Nelsont345/Driver-Fingerprint-Scanner/Report/Screen Shots/Photo of Set up.jpg

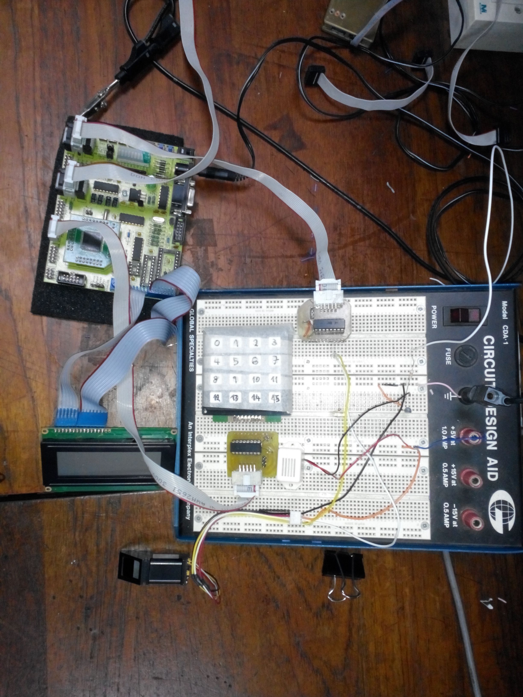
Report/Screen Shots/Photo of Set up.jpg
