Nelsont345/Driver-Fingerprint-Scanner/Report/Screen Shots/Welcome.jpg

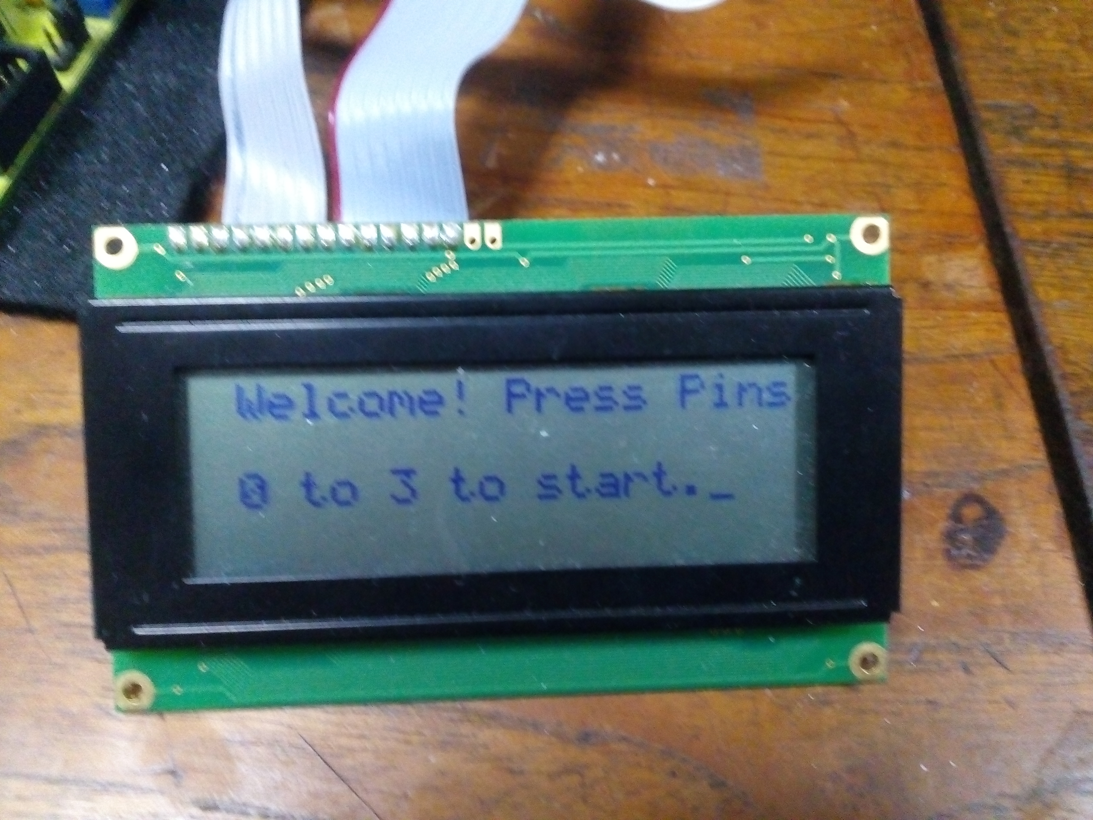
Report/Screen Shots/Welcome.jpg
