Nelsont345/Driver-Fingerprint-Scanner/README.md

# Driver-Fingerprint-Scanner
#A fingerprint scanner using a ATmega128 microprocessor
#and a Zhiantec zfm206 fingerprint module
