Nelsont345/Driver-Fingerprint-Scanner/PRoject Asssembly/version 12 working Action 1.txt

;Copyright (c) 2013 Manolis Agkopian		    
;See the file LICENCE for copying permission.	    ;
;;;;;;;;;;;;;;;;;;;;;;;;;;;;;;;;;;;;;;;;;;;;;;;;;;;;;

	.DEVICE ATmega128
	.include "m128def.inc"

;""""""""""""""""""""""""""""""""""""""""""""""""""""""""""""""""""""""
		jmp Init		                 ; jmp is 2 word instruction to set correct vector 

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

.org		$0080			; start address well above interrupt table

;""""""""""""""""""""""""""""""""""""""""""""""""""""""""""""""""""""""""""""

init:

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

.equ	testregister= 0x0352           ;used for interrupt
.equ	testregister1= 0x037B
.equ    testregister2 = 0x03A4
.equ    testregister3 = 0x03CD      ;not in use 
.equ    testregister4 = 0x03F6

.equ    testregister5 = 0x041F
.equ    testregister6 = 0x0448
.equ    testregister7 = 0x0471
.equ    testregister8 = 0x049A 
.equ	testregister9 = 0x04C3  

;*****    Registers    *****
.def	bitcounter  = R24				;??
.def	temp	    = R16			;COUNTER?
.def	UART_buffer = R23			;WHat IS BUFFER?

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

		;######################################################################

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

img2tBuff1:
.db $EF,$01,$FF,$FF,$FF,$FF,$01,$00,$04,$02,$1,$00,$08,$0

img2tBuff2:
.db $EF,$01,$FF,$FF,$FF,$FF,$01,$00,$04,$02,$2,$00,$09,$0

regmodel:
.db $EF,$01,$FF,$FF,$FF,$FF,$01,$00,$03,$05,$00,$09    

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

PreciseMatch:
.db $EF,$01,$FF,$FF,$FF,$FF,$01,$00,$03,$03, $00, $07,$08,$00

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

;****************************************************
;**********************CODE HERE*********************
;****************************************************

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

; 12 cycles here (without delays)
uart_send_next_bit:	
	brcc	uart_send_1
	cbi		UART_TxPort, TxD
	rjmp	uart_wait

uart_send_1:	
	sbi		UART_TxPort, TxD
	nop

uart_wait:	
	rcall 	UART_delay	
	rcall 	UART_delay

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

UART_get_byte:	
	ldi 	bitcounter, 9

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

; 10 cycles here (without delays)
uart_get_bit:	
	rcall 	UART_delay	
	rcall 	UART_delay		

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

uart_bit_done:	
	ret

;****************************************************
;*****                UART DELAY                *****
;****************************************************
; 3*b + const_delay_cycles
UART_delay:	
	lds		temp, DELAY_VALUE
UART_delay1:	

	dec		temp
	brne	UART_delay1
	nop
	;pop r16
	ret

uart_init:
              ;set portD as I/O

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

	ldi temp, $01
	ret
;**************************  MAIN ***************************************
;***********************************************************************
;******************************************************************
;******************************************************************
;******************************************************************
;******************************************************************
;******************************************************************
;******************************************************************
;******************************************************************
;******************************************************************
;******************************************************************
;******************************************************************

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

; +++++++++++++++++++++++++++++++++  ACTION 1 +++++++++++++++++++++++++++++++++++
action1:
	rcall Print1
Print2:
	ldi YH, high(testregister2) ;3A4     regmodel gets recorded
	ldi YL, low(testregister2)
	rcall send_genimg
	rcall BigDEL
	rcall BigDEL
	/*
	push r20
	lds r20, 0x035B     ;change
	cpi  r20, $00
	brne Print2
	pop r20	
	*/
	ldi YH, high(testregister3) ;3CD    Match gets recorded
	ldi YL, low(testregister3)
	rcall send_img2tBuff2	
	rcall BigDEL
	rcall BigDEL
	ldi YH, high(testregister4) ;3fB     Match gets recorded
	ldi YL, low(testregister4)
	rcall send_regmodel
	rcall BigDEL
	rcall BigDEL
	
	push r20
	ldi r20, $BB
	out portb, r20
		pop r20	
	rcall BigDEL
	ldi YH, high(testregister5) ;41F     Match gets recorded
	ldi YL, low(testregister5)
	rcall send_PreciseMatch
	rcall BigDEL
	rcall BigDEL

	rcall compare_basic2 
	ret 
; +++++++++++++++++++++++++++++++++  ACTION 2 +++++++++++++++++++++++++++++++++++
action2:   ;Keep
	out portb, r30
	rcall send_genimg	

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

	ret

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

	rcall send_LoadCharBuffer1
	rcall send_LoadCharBuffer2

	rcall send_PreciseMatch
	rcall compare_basic2
	rcall megadel
	;rcall send_LoadCharBuffer2    ;load charbuffer from location 1, as Char 2

	;rcall send_regmodel
	;rcall save_data_start5
	;rcall send_Search
	;rcall save_data_start49A         ;match before storing
	;rcall compare_basic2 
	;rcall megadel

	ret

Print1:
	ldi YH, high(testregister) 
	ldi YL, low(testregister)    ;352     ;getting ff, expecting 00
	rcall send_genimg		   
	rcall BigDEL
	rcall BigDEL

	ldi YH, high(testregister1) ;37B
	ldi YL, low(testregister1) 
	rcall send_img2tBuff1  
	rcall BigDEL
	rcall BigDEL
	push r19
	ldi r19, $AA
	out portb, r19
	pop r19	
	ret

;XXXXXXXXXXXXXXXXXXXXXXXXXXXXXXX  Beginning OF RETURN    XXXXXXXXXXXXXXXXXXXXXXXXXXXXXXXXXXXXXXXXX
;XXXXXXXXXXXXXXXXXXXXXXXXXXXXXXX  Beginning OF RETURN    XXXXXXXXXXXXXXXXXXXXXXXXXXXXXXXXXXXXXXXXX

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

;^^^^^^^^^^^^^^^^^^^^^^^^^^^^^^^^^^DATABASE TO SRAM^^^^^^^^^^^^^^^^^^^^^^^^^^^^^^^^^^

DATABASE_TO_SRAM: ;saves to 0x0300
push r20
compare_database:

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

	;end if counted
	cpi r20, $0
	breq program_to_memory_end
	rjmp program_to_memory

program_to_memory_end:
	pop r20
	ret

;^^^^^^^^^^^^^^^^^^^^^^^^^^^^^^^^^^DATABASE TO SRAM  END^^^^^^^^^^^^^^^^^^^^^^^^^^^^^^^^^^
 ;*********************************COMPARING1**************************************

; in this routine we are going to compare 2 sram databases
compare_basic2:

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

Comp1Out2Z:	;the one we compare to

			  LDI ZH, HIGH(compare_address)    ;address for comparison 
              LDI ZL, LOW(compare_address)
			  ret
Comp1Out2Y:
              ldi YL, low(testregister5)           ;saved output from MAtch
			  ldi YH, high(testregister5) 
			  ret

Comp1More2:

			ld r20, Z+
			ld r17, Y+

			inc r18

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

			cpi r18, 10 ; compare when end the cycle		 ;chnaged to 8 for matching	
			brne Comp1More2

Comp1End2:     

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

			pop r18
			pop r21
			pop r20
			pop r17
			ret

statefalse2:
	push r22
	ldi r22, $0F
	out portB, r22
	 ;ldi r25, 0  ;to end the loop
	pop r22
	rcall bigdel
	;rjmp statefalse2

	pop r18
	pop r21
	pop r20
	pop r17
	ret
	;rjmp sendloop

;XXXXXXXXXXXXXXXXXXXXXXXXXXXXXXX  END OF RETURN    XXXXXXXXXXXXXXXXXXXXXXXXXXXXXXXXXXXXXXXXX
;XXXXXXXXXXXXXXXXXXXXXXXXXXXXXXX  END OF RETURN    XXXXXXXXXXXXXXXXXXXXXXXXXXXXXXXXXXXXXXXXX

;&&&&&&&&&&&&&&&&&&&&&&&&&&&&&&&  SENDING PACKAGES &&&&&&&&&&&&&&&&&&&&&&&&&&&&&&&&&&&&&&&&&

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

;*************************************SEND BYTE BY BYTE****************************************
	  
Mess1Out:
			push r17

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

;*************************************** LCD ROutines

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

;%%%%%%%%%%%%%%%%%%%%%%%%%%%%    Interrupt   %%%%%%%%%%%%%%%%%%%%%%%%%%%%%%%

save_data_start352:

push r17
lds r17, UDR1
;out portb, r17
st Y+, r17 ; store bit received to UART to memomry location
pop r17
;rcall megadel
;cpi YL, $61
;breq end
reti

/*
end:
	cli
	ldi YL, $52
	ret
*/
/*

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

;%%%%%%%%%%%%%%%%%%%%%%%%%%%%    10th    %%%%%%%%%%%%%%%%%%%%%%%%%%%%%%%
save_data_start49A:
	push r20

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

	 ldi ZH, high(testregister92) ;create 16 bit address, create *2?
	 ldi ZL, low(testregister92)

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

	 ;%%%%%%%%%%%%%%%%%%%%%%%%%%%%%%%%%%%%%%%%%%%%%%%%

*/

megadel:
	rcall BigDEL
	rcall BigDEL
	rcall BigDEL
	rcall BigDEL
	rcall BigDEL
	rcall BigDEL
	rcall BigDEL
	rcall BigDEL
	rcall BigDEL
	rcall BigDEL
	ret

; ~~~~~~~~~~~~~~~~~~~~~~~~~~~~~~~~~~~~~~~~ WAIT FOR  BUTTION PRESS AND MOVE SOMWEHRE ~~~~~~~~~~~

waitforbuttonpress:
	
    ;ldi r21,$00
	in r21, PIND

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

	cpi r21, $EF ; PIN4
	breq action4call ;Action 4

	ret

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
