Nelsont345/Driver-Fingerprint-Scanner/PRoject Asssembly/version 4.txt

;Copyright (c) 2013 Manolis Agkopian		    
;See the file LICENCE for copying permission.	    ;
;;;;;;;;;;;;;;;;;;;;;;;;;;;;;;;;;;;;;;;;;;;;;;;;;;;;;

	.DEVICE ATmega128
	.include "m128def.inc"

;***** Pin definitions *****
.equ	UART_TxPort = PORTD    ;set port D aS OUTPUT FOR TRANSMIT
.equ	UART_TxDDR  = DDRD				;DIRECTION REGISTER
.equ	UART_RxPin  = PIND				;sET PIN D FOR READ
.equ	UART_RxDDR  = DDRD					;DIRECTION REGISTER
.equ	RxD	= 2							;set pin  2 as receive, might be a different pin
.equ	TxD	= 3								;set pin 3 as transmit

;.equ	savedregister=0x0200      ;Address in SRAM, where the new database will be stored
.equ	savedregister=0x0300      ;Address in SRAM, where the new database will be stored
.equ	compare_address = 0x0C00

;*****    Registers    *****
.def	bitcounter  = R24				;??
.def	temp	    = R17			;COUNTER?
.def	UART_buffer = R23			;WHat IS BUFFER?

;*****  Speed setting  *****
.equ	CRYSTAL_FREQ = 8000000   ;SET READ/ WRITE TO BE EQUAL, 8MHZ, now 1
.equ	BAUD 		 =  57600  ;57600     ;bits per second, rate ;9600

;*****       Etc       *****
.equ	stop_bits 	       = 1     ;STOPS READING
; hand-picked for easier auto-baud calculations (no division)
.equ	cycles_per_bit 	   = 12 ;without delays + 4*nop
.equ	const_delay_cycles = 9	;rjmp + ret + 2*nop

; byte in ram that keeps speed
.dseg
DELAY_VALUE: .byte 1        ;assign memory for clock speed value?
.cseg

;***** Precalculations *****
;pure cycles necessary per bit
.equ	c = CRYSTAL_FREQ / BAUD			;relates clock speed to transmission
;delay cycles
.equ	d = (c - cycles_per_bit - 2*const_delay_cycles)/2
;delay value	
.equ	b = d / 3						;divison by 3 of d, definition

; throw error if we're out of bounds
.if b > 255
	.error "Baud rate is too low!"		;check if transmission speed is correct
.elif b <= 0
	.error "Baud rate is too high!"
.endif

; ******* Port B Setup Code ****  
		ldi r16, $FF		; will set to outputs so i cab use Leds for debugging
		out DDRB , r16		; Port B Direction Register
		ldi r16, 00		; Who cares what is it....
		out PORTB, r16		; Port B value

		ldi r16, $0F		; Stack Pointer Setup
		out SPH,r16			; Stack Pointer High Byte 
		ldi r16, $FF		; Stack Pointer Setup 
		out SPL,r16			; Stack Pointer Low Byte 
rjmp main
;****************************************************
;**********************CODE HERE*********************
;****************************************************

;****************************************************
;*****                 SEND BYTE                *****
;****************************************************
; UART_buffer -> UART
UART_send_byte:	
	ldi		bitcounter, 9 + stop_bits ;CHECK IF CORRECRT, 7 + stop_bits
	com		UART_buffer	
	sec		

; 12 cycles here (without delays)
uart_send_next_bit:	
	brcc	uart_send_1
	cbi		UART_TxPort, TxD
	rjmp	uart_wait

uart_send_1:	
	sbi		UART_TxPort, TxD
	nop

uart_wait:	
	rcall 	UART_delay	
	rcall 	UART_delay

	nop	nop nop nop
	lsr		UART_buffer
	dec		bitcounter		
	brne	uart_send_next_bit
					
	sbi		UART_TxPort, TxD
	ret		
		
;****************************************************
;*****                 GET BYTE                 *****
;****************************************************
; UART -> UART_buffer
UART_get_byte:	
	ldi 	bitcounter, 9

uart_wait_for_start:	
	sbic 	UART_RxPin, RxD	
	rjmp 	uart_wait_for_start
	;synchronize for 0.5 bit length
	rcall 	UART_delay	

; 10 cycles here (without delays)
uart_get_bit:	
	rcall 	UART_delay	
	rcall 	UART_delay		

	clc			
	sbic 	UART_RxPin, RxD	;RxD is a pin where out data will appear bit by bit
	sec			
	
	nop	nop nop nop
	dec 	bitcounter		
	breq 	uart_bit_done	
				
	ror 	UART_buffer		
	rjmp 	uart_get_bit	

uart_bit_done:	
	ret

;****************************************************
;*****                UART DELAY                *****
;****************************************************
; 3*b + const_delay_cycles
UART_delay:	
	lds		temp, DELAY_VALUE
UART_delay1:	
	dec		temp
	brne	UART_delay1
	nop
	ret

;****************************************************
;*****              UART AUTO-BAUD              *****
;****************************************************
; calculates calc_b after receiving 0x55
; calc_b -> temp
; intermediate result is c/6
; sbis (2) + inc (1) + breq (2) + nop (1)
/*
UART_autocalibrate:
	clr 	temp
	
uart_cal_wait_start:	
	sbic 	UART_RxPin, RxD	
	rjmp 	uart_cal_wait_start

uart_cal_wait_bit:	
	sbis 	UART_RxPin, RxD	
	rjmp 	uart_cal_wait_bit

uart_measure_bit:
	sbis 	UART_RxPin, RxD		
	rjmp 	uart_calibration_done
	nop
	inc		temp
	breq	uart_calibration_fail

uart_calibration_done:
	; b = c/6 - cycles_per_bit/6 - const_delay_cycles/3
	; temp = c/6
	cpi		temp, cycles_per_bit/6
	brlo	uart_calibration_fail
	subi	temp, cycles_per_bit/6

	cpi		temp, const_delay_cycles/3
	brlo	uart_calibration_fail
	subi	temp, const_delay_cycles/3

	sts		DELAY_VALUE, temp

uart_calibration_fail:
	ret
*/
;****************************************************
;*****               UART REINIT                *****
;****************************************************
; just resets DELAY_VALUE to default
uart_reinit:

	in		temp, UART_TxDDR
	ori		temp, (1<<TxD)
	out		UART_TxDDR, temp
	sbi		UART_TxPort, TxD

	in		temp, UART_RxDDR
	andi	temp, ~(1<<RxD) 
	out		UART_RxDDR, temp

	ldi		temp, b
	sts		DELAY_VALUE, temp
	ret

	ldi temp, $01
	ret
;**************************  MAIN ***************************************
;***********************************************************************
;******************************************************************
;******************************************************************
;******************************************************************
;******************************************************************
;******************************************************************

main:
	;rcall Idisp
	rcall uart_reinit
	;rcall Mess1Out
	;rcall save_data_start
sendloop:

	;ldi UART_buffer, $40
	; call sending rmess routinge
	;rcall Mess1Out
	;call save_data_start
	rcall DATABASE_TO_SRAM
	;rcall compare_basic
	
	;lds r16, 0x0309
	;out portb, r16
	;mov r22, UART_buffer
	;out portb, r22
	;rcall DEL49ms

	;rcall UART_send_byte
	; UART BUFFER is the data to send

	rjmp sendloop

;XXXXXXXXXXXXXXXXXXXXXXXXXXXXXXX  Beginning OF RETURN    XXXXXXXXXXXXXXXXXXXXXXXXXXXXXXXXXXXXXXXXX
;XXXXXXXXXXXXXXXXXXXXXXXXXXXXXXX  Beginning OF RETURN    XXXXXXXXXXXXXXXXXXXXXXXXXXXXXXXXXXXXXXXXX

save_data_start:
	push r20
	 ldi XH, high(savedregister*2) ;create 16 bit address
	 ldi XL, low(savedregister*2)
	 ldi r25, 12
	 ; memory initisised
save_data: ; 12 bytes to collect - collect byte by byte
	rcall UART_get_byte	
	mov r22, UART_buffer
	;out portb, r22
	;set up memory for input i.e what is saved in r22
	;use SRAM 
	st X+, r22         ;store 8 bits wiht a 16 bit address in SRAM
	;lds r20, 0x0208     ;verification  steps
	;cpi r20, $03
	;breq stahp

	Dec r25
	cpi  r25, 0
	brne save_data ; if it is zero just go on
	pop r20
	ret
	
stahp:           ;verifcation steps
	out portB, r20
	ret

;^^^^^^^^^^^^^^^^^^^^^^^^^^^^^^^^^^DATABASE TO SRAM^^^^^^^^^^^^^^^^^^^^^^^^^^^^^^^^^^

DATABASE_TO_SRAM: ;saves to 0x0C00  WHYYY WHY THEFUCK WHYY I HATE THIS SO MUCH FUCK YOU AVR ASSEWMBLY
push r20
compare_database:
;.db $EF, $01, $FF, $FF, $FF, $FF, $07,$00, $03, $00, $00, $0C  ;changed Byte 9 from 02 to 00
.db $FF, $FF, $FF, $FF, $FF, $FF, $FF,$FF, $FF, $FF, $FF, $FF 
makingZalocation:
	ldi XH, high(compare_address*2) ;create 16 bit address
	ldi XL, low(compare_address*2)

	ldi ZH, HIGH(compare_database*2)  ;
    ldi ZL, LOW(compare_database*2)
	ldi r20, 12  ;counter

	;address
	
program_to_memory:
	lpm 
	;mov r19, r0 ;r19 cointans byte by byte
	ADIW ZL, $01
	dec r20
	
	;now you have data in r19 and you want to store it
	
	st X+, r0

	;end if counted
	cpi r20, $0
	breq program_to_memory_end
	rjmp program_to_memory

program_to_memory_end:
	pop r20
	ret

;^^^^^^^^^^^^^^^^^^^^^^^^^^^^^^^^^^DATABASE TO SRAM  END^^^^^^^^^^^^^^^^^^^^^^^^^^^^^^^^^^
 ;*********************************COMPARING**************************************

 ; this should be loaded only once

generateX:
.db 0x300, 0x301, 0x302, 0x303, 0x304, 0x305, 0x306, 0x307, 0x308, 0x309, 0x310, 0x311
ret

compare_data:
; this is responce code
;.db $0A, $00, $00, $03, $00, $07, $FF, $FF, $FF, $FF, $01, $EF
.db $EF, $01, $FF, $FF, $FF, $FF, $07,$00, $03, $02, $00, $0C

compare_basic:

ldi r20, $02 ;means nothing
ldi r18, 0  ;means nothing too
LDI r25, 12 ;number of characters or bytes ; this displays the number of r18 ; to send command 13

; po0int x to the memory
;ldi XL, low(generateX*2)
;ldi XH, high(generateX*2) ; was senddataregister

; do not repeat the thing above

Comp1Out:	;the one we compare to

			  LDI ZH, HIGH(compare_data*2)
              LDI ZL, LOW(compare_data*2)
              
Comp1More:
              LPM  ;isssue loading SRAM and incrementing

			  ; at this point we have Z(compare) in r18
			  ;we want to move this to store in different register
			  mov r19, r0 ; r19 is out test data from Z(compare message)
			  ADIW ZL, $01
			  ;now get X stuff in the memory
			  ;rcall generateX
			  ldi zL, low(generateX*2)
			  ldi zH, high(generateX*2)
			  lpm ; do not know shy this is here
			  mov r21,r0 ; move the X from r0
			  ld r18, X+ ; not sure if it is decremnenting  ;X is just r26?
			  ; now you have the value  of memory address in r18 one by one
				; r18 is X, r19 is Z
			   
			  ;rcall BigDEL
              cp r19, r18	;compaer X (memory) and Z		  ( message database)
			  brne statefalse
			  ;out portB, r20
			;rcall UART_delay
			;rcall bigdel
			;rcall bigdel
			;rcall bigdel
			;rcall bigdel

			  DEC r25
			  ;ADIW XL, $01
			  ADIW ZL, $01
			  cpi r25, $0			 
			  breq Comp1End
			  ;ADIW ZL, $01
			  rjmp Comp1More
			  ; if r18>0 then retrurn to mess1more
Comp1End:     

			rjmp sendloop

statefalse:
	push r22
	ldi r22, $0F
	out portB, r22
	; ldi r25, 0  to end the loop
	pop r22
	ret
	;rjmp sendloop

;XXXXXXXXXXXXXXXXXXXXXXXXXXXXXXX  END OF RETURN    XXXXXXXXXXXXXXXXXXXXXXXXXXXXXXXXXXXXXXXXX
;XXXXXXXXXXXXXXXXXXXXXXXXXXXXXXX  END OF RETURN    XXXXXXXXXXXXXXXXXXXXXXXXXXXXXXXXXXXXXXXXX

Mess1:
;.db $0F, $0

;.db $0,$0, $FF, $FF ,$0,$0
;.db $0F, $0

;Handshake
;.db $EF,$01,$FF,$FF,$FF,$FF,$01,$00,$04,$17,$00,$00,$1C,$00

;genimg
.db $EF,$01,$FF,$FF,$FF,$FF,$01,$00,$03,$01,$00,$05,$01,$00

;.db $0F, $0F
;
Mess1Out:
push r17
              LDI ZH, HIGH(2*Mess1)
              LDI ZL, LOW(2*Mess1)
              LDI r18, 12 ;number of characters or bytes ; this displays the number of r18 ; to send command 13
Mess1More:
              LPM 
              MOV r17, r0
              mov UART_buffer,r17
			  rcall UART_send_byte
              ;rcall Mess1LCD ; send it To LCD
			  ;rcall busylcd
              
			  ;delay this
			
			;rcall UART_delay
			;rcall UART_delay
			rcall UART_delay

			  DEC r18
			  cpi r18, $0
			  breq Mess1End
			  ADIW ZL, $01
			  rjmp Mess1More
			  ; if r18>0 then retrurn to mess1more
Mess1End:     
			pop r17
			ret

;*************************************** LCD ROutines

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

        ret              ;return if clear
;
;********************   DELAY ROUTINES ********************************************
BigDEL:
             rcall Del49ms
             rcall Del49ms
             rcall Del49ms
             rcall Del49ms
             rcall Del49ms
             ret
;
DEL15ms:
;
; This is a 15 msec delay routine. Each cycle costs
; rcall           -> 3 CC
; ret              -> 4 CC
; 2*LDI        -> 2 CC 
; SBIW         -> 2 CC * 19997
; BRNE        -> 1/2 CC * 19997
; 

            LDI XH, HIGH(19997)
            LDI XL, LOW (19997)
COUNT:  
            SBIW XL, 1
            BRNE COUNT
            RET
;
DEL4P1ms:
            LDI XH, HIGH(5464)
            LDI XL, LOW (5464)
COUNT1:
            SBIW XL, 1
            BRNE COUNT1
            RET 
;
DEL100mus:
            LDI XH, HIGH(131)
            LDI XL, LOW (131)
COUNT2:
            SBIW XL, 1
            BRNE COUNT2
            RET 
;
DEL49ms:
            LDI XH, HIGH(65535)
            LDI XL, LOW (65535)
COUNT3:
            SBIW XL, 1
            BRNE COUNT3
            RET
