Nelsont345/Driver-Fingerprint-Scanner/PRoject Asssembly/version 5, responds to finger.txt

;Copyright (c) 2013 Manolis Agkopian		    
;See the file LICENCE for copying permission.	    ;
;;;;;;;;;;;;;;;;;;;;;;;;;;;;;;;;;;;;;;;;;;;;;;;;;;;;;

	.DEVICE ATmega128
	.include "m128def.inc"

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

;.equ	savedregister=0x0200      ;Address in SRAM, where the new database will be stored
.equ	savedregister=0x0300      ;Address in SRAM, where the new database will be stored
.equ	compare_address = 0x0400

;*****    Registers    *****
.def	bitcounter  = R24				;??
.def	temp	    = R16			;COUNTER?
.def	UART_buffer = R23			;WHat IS BUFFER?

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

; 12 cycles here (without delays)
uart_send_next_bit:	
	brcc	uart_send_1
	cbi		UART_TxPort, TxD
	rjmp	uart_wait

uart_send_1:	
	sbi		UART_TxPort, TxD
	nop

uart_wait:	
	rcall 	UART_delay	
	rcall 	UART_delay

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

uart_wait_for_start:	
	sbic 	UART_RxPin, RxD	
	rjmp 	uart_wait_for_start
	;synchronize for 0.5 bit length
	rcall 	UART_delay	

; 10 cycles here (without delays)
uart_get_bit:	
	rcall 	UART_delay	
	rcall 	UART_delay		

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

uart_bit_done:	
	ret

;****************************************************
;*****                UART DELAY                *****
;****************************************************
; 3*b + const_delay_cycles
UART_delay:	
	lds		temp, DELAY_VALUE
UART_delay1:	
	dec		temp
	brne	UART_delay1
	nop

	ret

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

uart_cal_wait_bit:	
	sbis 	UART_RxPin, RxD	
	rjmp 	uart_cal_wait_bit

uart_measure_bit:
	sbis 	UART_RxPin, RxD		
	rjmp 	uart_calibration_done
	nop
	inc		temp
	breq	uart_calibration_fail

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

	cpi		temp, const_delay_cycles/3
	brlo	uart_calibration_fail
	subi	temp, const_delay_cycles/3

	sts		DELAY_VALUE, temp

uart_calibration_fail:
	ret
*/
;****************************************************
;*****               UART REINIT                *****
;****************************************************
; just resets DELAY_VALUE to default
uart_reinit:

	in		temp, UART_TxDDR
	ori		temp, (1<<TxD)
	out		UART_TxDDR, temp
	sbi		UART_TxPort, TxD

	in		temp, UART_RxDDR
	andi	temp, ~(1<<RxD) 
	out		UART_RxDDR, temp

	ldi		temp, b
	sts		DELAY_VALUE, temp
	ret

	ldi temp, $01
	ret
;**************************  MAIN ***************************************
;***********************************************************************
;******************************************************************
;******************************************************************
;******************************************************************
;******************************************************************
;******************************************************************
;******************************************************************
;******************************************************************
;******************************************************************
;******************************************************************
;******************************************************************

main:                                ;!!!!!!!!!!!!RUNS ONCE HERE
	;rcall Idisp
	rcall uart_reinit
	rcall DATABASE_TO_SRAM ;this takes the compasioson message and saves that in memorry at 0x0400
	
sendloop:
	
	rcall Mess1Out ; this send message to the deiv ce
	rcall save_data_start ; this takes the message from device and savedss to sram, at  0x0300
	rcall compare_basic2
	;ldi UART_buffer, $40
	; call sending rmess routinge
	;rcall Mess1Out
	;call save_data_start

	;rcall compare_basic2
	
	;lds r16, 0x0309
	;out portb, r16
	;mov r22, UART_buffer
	;out portb, r22
	;rcall DEL49ms

	;rcall UART_send_byte
	; UART BUFFER is the data to send

	rjmp sendloop

;******************************************************************
;******************************************************************
;******************************************************************
;******************************************************************
;******************************************************************

;XXXXXXXXXXXXXXXXXXXXXXXXXXXXXXX  Beginning OF RETURN    XXXXXXXXXXXXXXXXXXXXXXXXXXXXXXXXXXXXXXXXX
;XXXXXXXXXXXXXXXXXXXXXXXXXXXXXXX  Beginning OF RETURN    XXXXXXXXXXXXXXXXXXXXXXXXXXXXXXXXXXXXXXXXX

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

;^^^^^^^^^^^^^^^^^^^^^^^^^^^^^^^^^^DATABASE TO SRAM^^^^^^^^^^^^^^^^^^^^^^^^^^^^^^^^^^

DATABASE_TO_SRAM: ;saves to 0x0C00  
push r20
compare_database:
.db $EF, $01, $FF, $FF, $FF, $FF, $07,$00, $03, $00, $00, $0A  ;changed Byte 9 from 02 to 00  ;cagnged byte 1 from EF to EE
;.db $11, $11, $FF, $FF, $FF, $00, $FF,$FF, $FF, $11, $FF, $AA 
makingZalocation:
	ldi XH, high(compare_address) ;create 16 bit address?
	ldi XL, low(compare_address)  ;Leave as 8 bit

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

	;end if counted
	cpi r20, $0
	breq program_to_memory_end
	rjmp program_to_memory

program_to_memory_end:
	pop r20
	ret

;^^^^^^^^^^^^^^^^^^^^^^^^^^^^^^^^^^DATABASE TO SRAM  END^^^^^^^^^^^^^^^^^^^^^^^^^^^^^^^^^^
 ;*********************************COMPARING1**************************************
 ;$$$$$$$$$$$$$$$$$$$$$$$$$$$$$$$$$$$$$$$$$$$$$$$$$$$$$$$$$$$$$$$$$$$$$$$$$$$$$$$$$$$$$$

 ; this should be loaded only once
 /*

generateX:
.db 0x300, 0x301, 0x302, 0x303, 0x304, 0x305, 0x306, 0x307, 0x308, 0x309, 0x310, 0x311
ret

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

compare_basic:

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

; do not repeat the thing above

Comp1Out:	;the one we compare to

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

			rjmp sendloop

statefalse:
	push r22
	ldi r22, $0F
	out portB, r22
	; ldi r25, 0  to end the loop
	pop r22
	ret
	;rjmp sendloop
*/
 ;$$$$$$$$$$$$$$$$$$$$$$$$$$$$$$$$$$$$$$$$$$$$$$$$$$$$$$$$$$$$$$$$$$$$$$$$$$$$$$$$$$$$$$
  ;*********************************COMPARING2*************************************

; in this routine we are going to compare 2 sram databases
compare_basic2:

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

Comp1Out2Z:	;the one we compare to

			  LDI ZH, HIGH(compare_address)   
              LDI ZL, LOW(compare_address)
			  ret
Comp1Out2Y:
              ldi YL, low(savedregister)
			  ldi YH, high(savedregister) 
			  ret

Comp1More2:
			;load Z to r20

			ld r20, Z+
			ld r17, Y+

			inc r18

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

			cpi r18, 12 ; compare when end the cycle			
			brne Comp1More2

Comp1End2:     
			pop r17
			pop r20
			push r21
			push r18
			rjmp sendloop

statefalse2:
	push r22
	ldi r22, $0F
	out portB, r22
	 ;ldi r25, 0  ;to end the loop
	pop r22
	rcall bigdel
	rcall bigdel
	;rjmp statefalse2
	ret
	;rjmp sendloop

;XXXXXXXXXXXXXXXXXXXXXXXXXXXXXXX  END OF RETURN    XXXXXXXXXXXXXXXXXXXXXXXXXXXXXXXXXXXXXXXXX
;XXXXXXXXXXXXXXXXXXXXXXXXXXXXXXX  END OF RETURN    XXXXXXXXXXXXXXXXXXXXXXXXXXXXXXXXXXXXXXXXX

Mess1:
;.db $0F, $0

;.db $0,$0, $FF, $FF ,$0,$0
;.db $0F, $0

;Handshake
;.db $EF,$01,$FF,$FF,$FF,$FF,$01,$00,$04,$17,$00,$00,$1C,$00

;genimg
.db $EF,$01,$FF,$FF,$FF,$FF,$01,$00,$03,$01,$00,$05,$01,$00

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

;*************************************** LCD ROutines

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
