Nelsont345/Driver-Fingerprint-Scanner/PRoject Asssembly/version 6b, img2tz seems ok.txt

;Copyright (c) 2013 Manolis Agkopian		    
;See the file LICENCE for copying permission.	    ;
;;;;;;;;;;;;;;;;;;;;;;;;;;;;;;;;;;;;;;;;;;;;;;;;;;;;;

	.DEVICE ATmega128
	.include "m128def.inc"

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

;.equ	savedregister=0x0200      ;Address in SRAM, where the new database will be stored
.equ	savedregister=0x0300      ;Address in SRAM, where the new database will be stored
.equ	compare_address = 0x0400
.equ	testregister= 0x0500

;*****    Registers    *****
.def	bitcounter  = R24				;??
.def	temp	    = R16			;COUNTER?
.def	UART_buffer = R23			;WHat IS BUFFER?

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

genimg:
.db $EF,$01,$FF,$FF,$FF,$FF,$01,$00,$03,$01, $00, $05,$08,$00

img2tBuff1:
.db $EF,$01,$FF,$FF,$FF,$FF,$01,$00,$04,$02,$1,$00,$08,$0

img2tBuff2:
.db $EF,$01,$FF,$FF,$FF,$FF,$01,$00,$04,$02,$2,$00,$09,$0

regmodel:
.db $EF,$01,$FF,$FF,$FF,$FF,$01,$00,$03,$05,$00,$09    

Store1:
.db $EF,$01,$FF,$FF,$FF,$FF,$01,$06,$00,$06,$01, $00, $01, $00, $0F, $00

rjmp main
;****************************************************
;**********************CODE HERE*********************
;****************************************************

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

; 12 cycles here (without delays)
uart_send_next_bit:	
	brcc	uart_send_1
	cbi		UART_TxPort, TxD
	rjmp	uart_wait

uart_send_1:	
	sbi		UART_TxPort, TxD
	nop

uart_wait:	
	rcall 	UART_delay	
	rcall 	UART_delay

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

uart_wait_for_start:	
	sbic 	UART_RxPin, RxD	
	rjmp 	uart_wait_for_start
	;synchronize for 0.5 bit length
	rcall 	UART_delay	

; 10 cycles here (without delays)
uart_get_bit:	
	rcall 	UART_delay	
	rcall 	UART_delay		

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

uart_bit_done:	
	ret

;****************************************************
;*****                UART DELAY                *****
;****************************************************
; 3*b + const_delay_cycles
UART_delay:	
	lds		temp, DELAY_VALUE
UART_delay1:	
	dec		temp
	brne	UART_delay1
	nop

	ret

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

uart_cal_wait_bit:	
	sbis 	UART_RxPin, RxD	
	rjmp 	uart_cal_wait_bit

uart_measure_bit:
	sbis 	UART_RxPin, RxD		
	rjmp 	uart_calibration_done
	nop
	inc		temp
	breq	uart_calibration_fail

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

	cpi		temp, const_delay_cycles/3
	brlo	uart_calibration_fail
	subi	temp, const_delay_cycles/3

	sts		DELAY_VALUE, temp

uart_calibration_fail:
	ret
*/
;****************************************************
;*****               UART REINIT                *****
;****************************************************
; just resets DELAY_VALUE to default
uart_reinit:

	in		temp, UART_TxDDR
	ori		temp, (1<<TxD)
	out		UART_TxDDR, temp
	sbi		UART_TxPort, TxD

	in		temp, UART_RxDDR
	andi	temp, ~(1<<RxD) 
	out		UART_RxDDR, temp

	ldi		temp, b
	sts		DELAY_VALUE, temp
	ret

	ldi temp, $01
	ret
;**************************  MAIN ***************************************
;***********************************************************************
;******************************************************************
;******************************************************************
;******************************************************************
;******************************************************************
;******************************************************************
;******************************************************************
;******************************************************************
;******************************************************************
;******************************************************************
;******************************************************************

main:                                ;!!!!!!!!!!!!RUNS ONCE HERE
	;rcall Idisp
	rcall uart_reinit
	rcall DATABASE_TO_SRAM ;this takes the compasioson message and saves that in memorry at 0x0400
	
sendloop:
	rcall send_genimg
	;rcall save_data_start	
	rcall save_data_start
	rcall send_img2tBuff1                ;SOMETHING WRONG WITH CHECKSUM
	rcall save_data_start2
	;rcall send_genimg	
	;rcall send_img2tBuff2                 ;SOMETHING WRONG WITH CHECKSUM
	;rcall send_regmodel
	;rcall send_Store1
	;rcall Mess1Out ; this send message to the deiv ce
	;rcall save_data_start ; this takes the message from device and savedss to sram, at  0x0300
	rcall compare_basic2

	;img2tBuff1, img2tBuff2, regmodel, Store1

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

	;rcall UART_send_byte
	; UART BUFFER is the data to send

	rjmp sendloop

;******************************************************************
;******************************************************************
;******************************************************************
;******************************************************************
;******************************************************************

;XXXXXXXXXXXXXXXXXXXXXXXXXXXXXXX  Beginning OF RETURN    XXXXXXXXXXXXXXXXXXXXXXXXXXXXXXXXXXXXXXXXX
;XXXXXXXXXXXXXXXXXXXXXXXXXXXXXXX  Beginning OF RETURN    XXXXXXXXXXXXXXXXXXXXXXXXXXXXXXXXXXXXXXXXX

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

;^^^^^^^^^^^^^^^^^^^^^^^^^^^^^^^^^^DATABASE TO SRAM^^^^^^^^^^^^^^^^^^^^^^^^^^^^^^^^^^

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

.db $EF, $01, $FF, $FF, $FF, $FF, $07,$00, $03, $00, $00, $0A    ;get IM

;.db $EF, $01, $FF, $FF, $FF, $FF, $07,$00, $03, $00, $00, $0A  ;

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

	;end if counted
	cpi r20, $0
	breq program_to_memory_end
	rjmp program_to_memory

program_to_memory_end:
	pop r20
	ret

;^^^^^^^^^^^^^^^^^^^^^^^^^^^^^^^^^^DATABASE TO SRAM  END^^^^^^^^^^^^^^^^^^^^^^^^^^^^^^^^^^
 ;*********************************COMPARING1**************************************
 ;$$$$$$$$$$$$$$$$$$$$$$$$$$$$$$$$$$$$$$$$$$$$$$$$$$$$$$$$$$$$$$$$$$$$$$$$$$$$$$$$$$$$$$

 ; this should be loaded only once
 /*

generateX:
.db 0x300, 0x301, 0x302, 0x303, 0x304, 0x305, 0x306, 0x307, 0x308, 0x309, 0x310, 0x311
ret

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

compare_basic:

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

; do not repeat the thing above

Comp1Out:	;the one we compare to

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

			rjmp sendloop

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

; in this routine we are going to compare 2 sram databases
compare_basic2:

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

Comp1Out2Z:	;the one we compare to

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

			ld r20, Z+
			ld r17, Y+

			inc r18

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

			cpi r18, 12 ; compare when end the cycle			
			brne Comp1More2

Comp1End2:     
			pop r17
			pop r20
			push r21
			push r18
			rjmp sendloop

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

;XXXXXXXXXXXXXXXXXXXXXXXXXXXXXXX  END OF RETURN    XXXXXXXXXXXXXXXXXXXXXXXXXXXXXXXXXXXXXXXXX
;XXXXXXXXXXXXXXXXXXXXXXXXXXXXXXX  END OF RETURN    XXXXXXXXXXXXXXXXXXXXXXXXXXXXXXXXXXXXXXXXX

;.db $0F, $0

;.db $0,$0, $FF, $FF ,$0,$0
;.db $0F, $0

;Handshake
;.db $EF,$01,$FF,$FF,$FF,$FF,$01,$00,$04,$17,$00,$00,$1C,$00

;genimg:
;.db $EF,$01,$FF,$FF,$FF,$FF,$01,$00,$04,$02, $01, $00,$08;

;img2t:
;.db $EF,$01,$FF,$FF,$FF,$FF,$01,$00,$04,$02,$1,$00,$05,$0

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

;img2tBuff1, img2tBuff2, regmodel, Store1			  
Mess1Out:
			push r17

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

;*************************************** LCD ROutines

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

;%%%%%%%%%%%%%%%%%%%%%%%%%%%%%%%%%%%%%%%%%%%%%%%%%%%%%%%%%%%%%%%%%%%%%%%
;%%%%%%%%%%%%%%%%%%%%%%  USELESS TEST   CODE  %%%%%%%%%%%%%%%%%%%%%%%%%%

save_data_start2:
	push r20
	 ldi XH, high(testregister) ;create 16 bit address, create *2?
	 ldi XL, low(testregister)
	 ldi r25, 12
	 ; memory initisised
save_data2: ; 12 bytes to collect - collect byte by byte
	rcall UART_get_byte	
	mov r22, UART_buffer
	;out portb, r22
	;set up memory for input i.e what is saved in r22
	;use SRAM 
	st X+, r22         ;store 8 bits wiht a 16 bit address in SRAM

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
