Nelsont345/Driver-Fingerprint-Scanner/PRoject Asssembly/version 9 not great.txt

;Copyright (c) 2013 Manolis Agkopian		    
;See the file LICENCE for copying permission.	    ;
;;;;;;;;;;;;;;;;;;;;;;;;;;;;;;;;;;;;;;;;;;;;;;;;;;;;;

	.DEVICE ATmega128
	.include "m128def.inc"

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

;*****    Registers    *****
.def	bitcounter  = R24				;??
.def	temp	    = R16			;COUNTER?
.def	UART_buffer = R23			;WHat IS BUFFER?

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

img2tBuff1:
.db $EF,$01,$FF,$FF,$FF,$FF,$01,$00,$04,$02,$1,$00,$08,$0

img2tBuff2:
.db $EF,$01,$FF,$FF,$FF,$FF,$01,$00,$04,$02,$2,$00,$09,$0

regmodel:
.db $EF,$01,$FF,$FF,$FF,$FF,$01,$00,$03,$05,$00,$09    

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

LoadCharBuffer2:
.db $EF,$01,$FF,$FF,$FF,$FF,$01,$00,$06,$07,$02, $00, $01, $00, $12, $00	;loading as char 2 , pritn 1

PreciseMatch:
.db $EF,$01,$FF,$FF,$FF,$FF,$01,$00,$03,$03, $00, $07,$08,$00

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

;****************************************************
;**********************CODE HERE*********************
;****************************************************

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

; 12 cycles here (without delays)
uart_send_next_bit:	
	brcc	uart_send_1
	cbi		UART_TxPort, TxD
	rjmp	uart_wait

uart_send_1:	
	sbi		UART_TxPort, TxD
	nop

uart_wait:	
	rcall 	UART_delay	
	rcall 	UART_delay

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

uart_wait_for_start:	
	sbic 	UART_RxPin, RxD	
	rjmp 	uart_wait_for_start
	;synchronize for 0.5 bit length
	rcall 	UART_delay	

; 10 cycles here (without delays)
uart_get_bit:	
	rcall 	UART_delay	
	rcall 	UART_delay		

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

uart_bit_done:	
	ret

;****************************************************
;*****                UART DELAY                *****
;****************************************************
; 3*b + const_delay_cycles
UART_delay:	
	lds		temp, DELAY_VALUE
UART_delay1:	
	dec		temp
	brne	UART_delay1
	nop

	ret

uart_reinit:

	in		temp, UART_TxDDR
	ori		temp, (1<<TxD)
	out		UART_TxDDR, temp
	sbi		UART_TxPort, TxD

	in		temp, UART_RxDDR
	andi	temp, ~(1<<RxD) 
	out		UART_RxDDR, temp

	ldi		temp, b
	sts		DELAY_VALUE, temp
	ret

	ldi temp, $01
	ret
;**************************  MAIN ***************************************
;***********************************************************************
;******************************************************************
;******************************************************************
;******************************************************************
;******************************************************************
;******************************************************************
;******************************************************************
;******************************************************************
;******************************************************************
;******************************************************************
;******************************************************************

main:  
                             ;!!!!!!!!!!!!RUNS ONCE HERE
	;rcall Idisp
	rcall uart_reinit
	rcall DATABASE_TO_SRAM ;this takes the compasioson message and saves that in memorry at 0x0400
main2:
	
	rcall waitforbuttonpress	
	rjmp main2
;rcall compare_basic2    	

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

; +++++++++++++++++++++++++++++++++  ACTION 1 +++++++++++++++++++++++++++++++++++
action1:
	rcall Print1
Print2:
	rcall send_genimg	
	rcall save_data_start3
	rcall send_img2tBuff2                 
	rcall save_data_start4
	push r20
	lds r20, 0x0384
	cpi  r20, $00
	brne Print2
	pop r20	
	
	rcall send_regmodel
	rcall save_data_start5
	rcall send_PreciseMatch
	rcall save_data_start10        ;match before storing

	push r20
	ldi r20, $BB
	out portb, r20
	rcall megadel
	pop r20	
	rcall compare_basic2 
	ret 

; +++++++++++++++++++++++++++++++++  ACTION 2 +++++++++++++++++++++++++++++++++++
action2:   ;Keep

	rcall send_genimg	
	rcall save_data_start3
	rcall send_img2tBuff2
	rcall send_regmodel
	rcall send_Store2             ;stores in lcation 1
	rcall save_data_start4
	ret

; +++++++++++++++++++++++++++++++++  ACTION 3 +++++++++++++++++++++++++++++++++++
action3:   ;Past
	rcall send_genimg	
	rcall send_img2tBuff1
	rcall save_data_start4
	rcall send_regmodel
	rcall save_data_start5
	push r20
	ldi r20, $BB
	out portb, r20
	rcall megadel
	pop r20	
	rcall send_LoadCharBuffer2    ;load charbuffer from location 1, as Char 2

	rcall send_regmodel
	rcall save_data_start6
	rcall send_PreciseMatch
	rcall save_data_start10        ;match before storing
	rcall compare_basic2 
	rcall megadel

	ret

	; +++++++++++++++++++++++++++++++++  ACTION 4 +++++++++++++++++++++++++++++++++++
action4:   ;Past
	;rcall print1	
	rcall send_genimg
	rcall send_img2tBuff1
	;rcall save_data_start2
	rcall send_regmodel
	;rcall save_data_start5
	push r20
	lds r20, 0x0384
	cpi  r20, $00
	brne action4
	pop r20	
	;rcall send_LoadCharBuffer2    ;load charbuffer from location 1, as Char 2

	;rcall send_regmodel
	;rcall save_data_start5
	rcall send_Search
	rcall save_data_start10        ;match before storing
	rcall compare_basic2 
	rcall megadel

	ret

;XXXXXXXXXXXXXXXXXXXXXXXXXXXXXXX  Beginning OF RETURN    XXXXXXXXXXXXXXXXXXXXXXXXXXXXXXXXXXXXXXXXX
;XXXXXXXXXXXXXXXXXXXXXXXXXXXXXXX  Beginning OF RETURN    XXXXXXXXXXXXXXXXXXXXXXXXXXXXXXXXXXXXXXXXX

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

;^^^^^^^^^^^^^^^^^^^^^^^^^^^^^^^^^^DATABASE TO SRAM^^^^^^^^^^^^^^^^^^^^^^^^^^^^^^^^^^

DATABASE_TO_SRAM: ;saves to 0x0300
push r20
compare_database:

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

	;end if counted
	cpi r20, $0
	breq program_to_memory_end
	rjmp program_to_memory

program_to_memory_end:
	pop r20
	ret

;^^^^^^^^^^^^^^^^^^^^^^^^^^^^^^^^^^DATABASE TO SRAM  END^^^^^^^^^^^^^^^^^^^^^^^^^^^^^^^^^^
 ;*********************************COMPARING1**************************************

; in this routine we are going to compare 2 sram databases
compare_basic2:

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

Comp1Out2Z:	;the one we compare to

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

			ld r20, Z+
			ld r17, Y+

			inc r18

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

			cpi r18, 10 ; compare when end the cycle		 ;chnaged to 8 for matching	
			brne Comp1More2

Comp1End2:     

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

			pop r18
			pop r21
			pop r20
			pop r17
			ret

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

	pop r18
	pop r21
	pop r20
	pop r17
	ret
	;rjmp sendloop

;XXXXXXXXXXXXXXXXXXXXXXXXXXXXXXX  END OF RETURN    XXXXXXXXXXXXXXXXXXXXXXXXXXXXXXXXXXXXXXXXX
;XXXXXXXXXXXXXXXXXXXXXXXXXXXXXXX  END OF RETURN    XXXXXXXXXXXXXXXXXXXXXXXXXXXXXXXXXXXXXXXXX

;&&&&&&&&&&&&&&&&&&&&&&&&&&&&&&&  SENDING PACKAGES &&&&&&&&&&&&&&&&&&&&&&&&&&&&&&&&&&&&&&&&&

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

;*************************************SEND BYTE BY BYTE****************************************
	  
Mess1Out:
			push r17

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

;*************************************** LCD ROutines

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

;%%%%%%%%%%%%%%%%%%%%%%%%%%%%%%%%%%%%%%%%%%%%%%%%%%%%%%%%%%%%%%%%%%%%%%%
;%%%%%%%%%%%%%%%%%%%%%%  USELESS TEST   CODE  %%%%%%%%%%%%%%%%%%%%%%%%%%

;%%%%%%%%%%%%%%%%%%%%%%%%%%%%    2nd     %%%%%%%%%%%%%%%%%%%%%%%%%%%%%%%

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

;%%%%%%%%%%%%%%%%%%%%%%%%%%%%    10th    %%%%%%%%%%%%%%%%%%%%%%%%%%%%%%%
save_data_start10:
	push r20

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

	 ldi ZH, high(testregister92) ;create 16 bit address, create *2?
	 ldi ZL, low(testregister92)

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

	 ;%%%%%%%%%%%%%%%%%%%%%%%%%%%%%%%%%%%%%%%%%%%%%%%%

megadel:
	rcall BigDEL
	rcall BigDEL
	rcall BigDEL
	rcall BigDEL
	rcall BigDEL
	rcall BigDEL
	rcall BigDEL
	rcall BigDEL
	rcall BigDEL
	rcall BigDEL
	ret

; ~~~~~~~~~~~~~~~~~~~~~~~~~~~~~~~~~~~~~~~~ WAIT FOR  BUTTION PRESS AND MOVE SOMWEHRE ~~~~~~~~~~~

waitforbuttonpress:
    ;ldi r21,$00
	in r21, PIND
	out portb, r21
	cpi r21, $FF
	breq waitforbuttonpress
	
	;here have list of conditions
	cpi r21,$FE ; pin 1
	breq action1call ; ACTION 1
	
	cpi r21, $FD ; PIN2
	breq action2call ; ACTION 2
	
	cpi r21, $FB ; PIN3
	breq action3call ;Action 3

	cpi r21, $F7 ; PIN4
	breq action4call ;Action 4

	ret

action1call:
	rcall action1
	ret
action2call:
	rcall action2
	ret
action3call:
	rcall action3
	ret
action4call:
	rcall action4
	ret
