Nelsont345/Driver-Fingerprint-Scanner/Report/Hardware/Schematics/Overall Schematic.pdf

Pins 0-3

data

Pins 4-7

Lower address

Pins 8-11

High

address

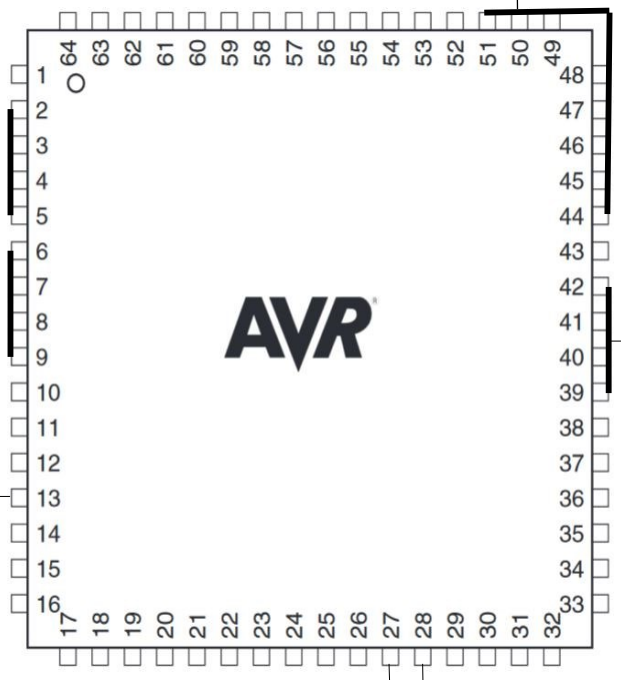
[picture p12: figure]

### 5V supply

### Pin 3 receive (Sensor)

### Pin 2 transmit

### (sensor)

# INCOMPLETE
