Nelsont345/Driver-Fingerprint-Scanner/tdmp5.pdf

Untitled Diagram.html | https://www.draw.io/#W01LEN3HPEAOUJHSXCSQFELOWC7JIL...

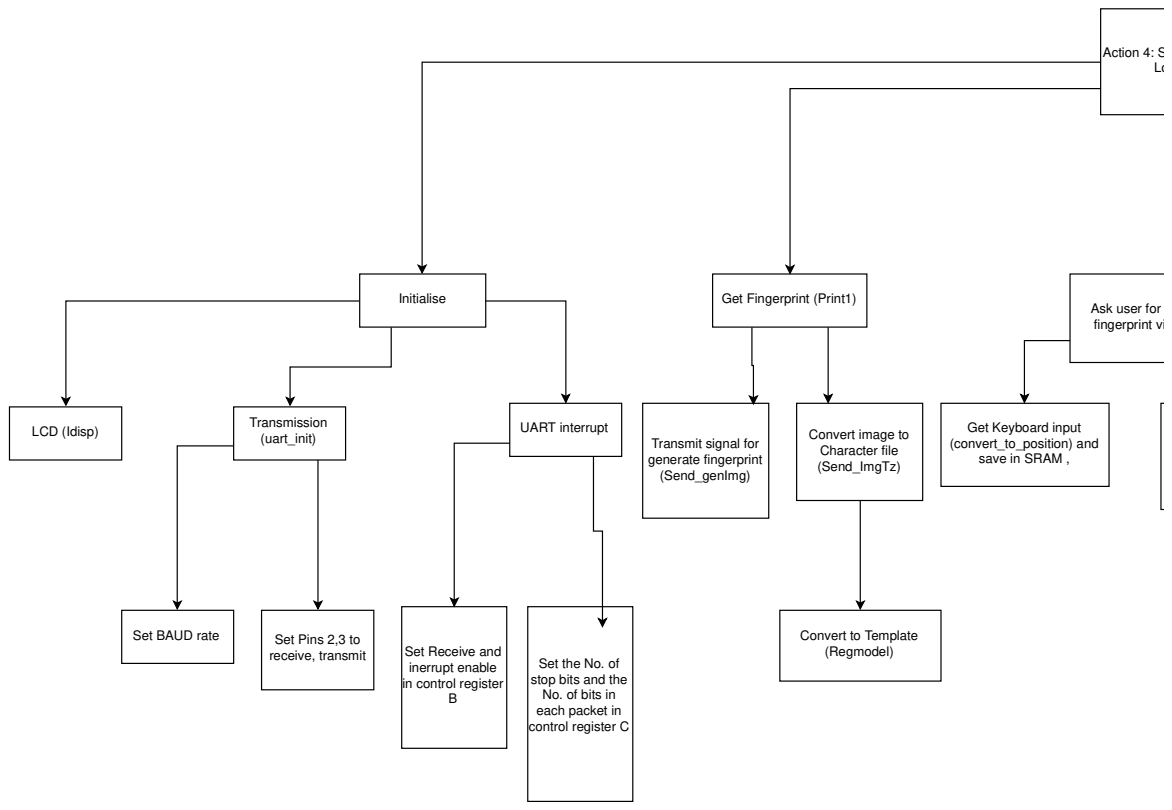
[picture p13: figure]
Action 4: Specific Memory Location; Initialise; LCD (Idisp); Set Receive and inerrupt enable in control register B; UART interrupt; Set BAUD rate; Set Pins 2,3 to; receive, transmit; Transmission (uart_init); Set the No. of stop bits and the No. of bits in each packet in control register C; Get Fingerprint (Print1); Transmit signal for generate fingerprint (Send_genImg); Convert image to Character file (Send_ImgTz); Ask user for ID of Comparison fingerprint via LCD (Ready2); Convert to Template (Regmodel); Get Keyboard input (convert_to_position) and save in SRAM ,

1 of 2 | 20/11/2017 13:45

Untitled Diagram.html | https://www.draw.io/#W01LEN3HPEAOUJHSXCSQFELOWC7JIL...

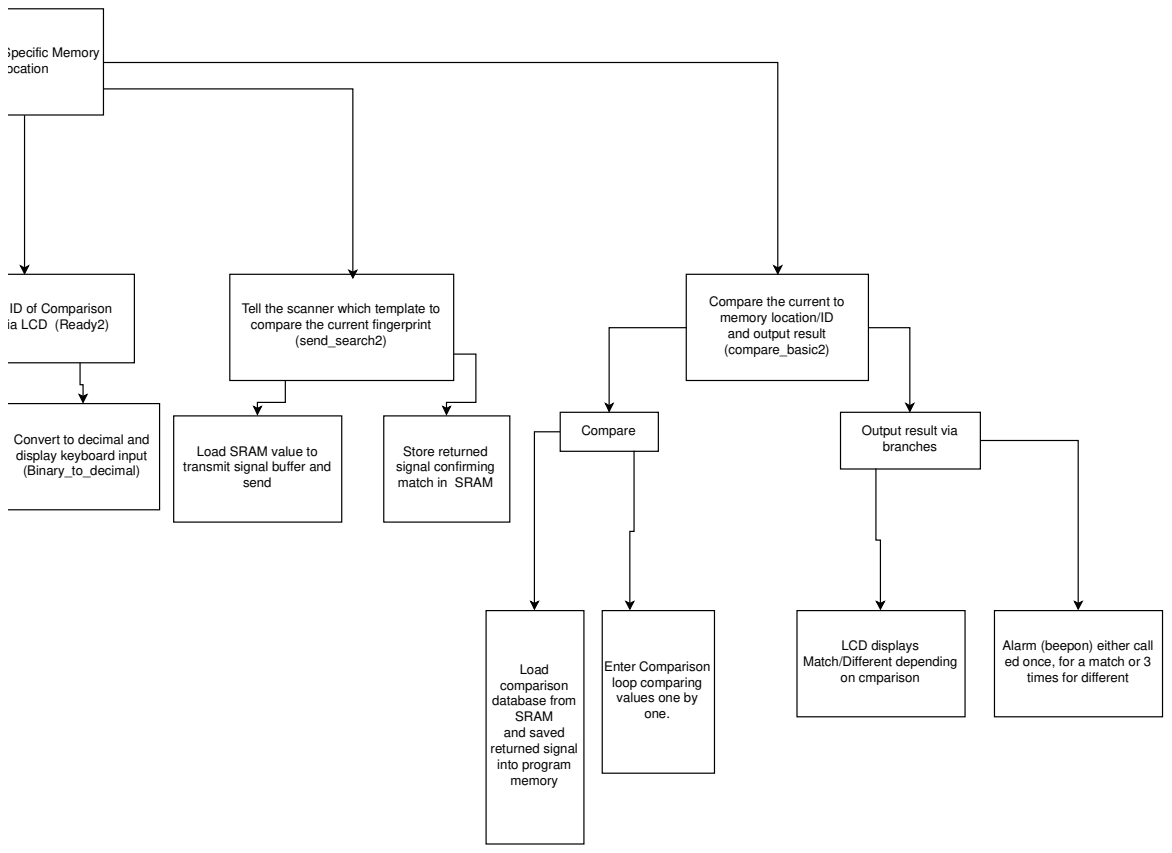
[picture p14: figure]
Location; Convert to decimal and display keyboard input (Binary_to_decimal); Tell the scanner which template to compare the current fingerprint (send_search2); Load SRAM value to transmit signal buffer and send; Store returned signal confirming match in SRAM; Compare the current to memory location/ID and output result (compare_basic2); Load comparison database from SRAM and saved returned signal into program memory; Compare; Enter Comparison loop comparing values one by one.; Output result via branches; LCD displays Match/Different depending on cmparison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

2 of 2 | 20/11/2017 13:45
