Nelsont345/Driver-Fingerprint-Scanner/Report/First Screen FLow map.JPG

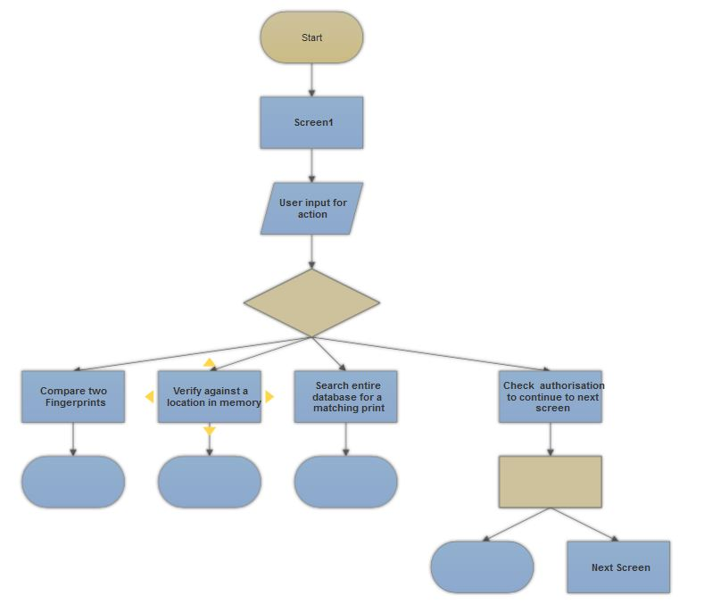
Report/First Screen FLow map.JPG
