Nelsont345/Driver-Fingerprint-Scanner/Report/Hardware/Keyboard/detailed keypad.png

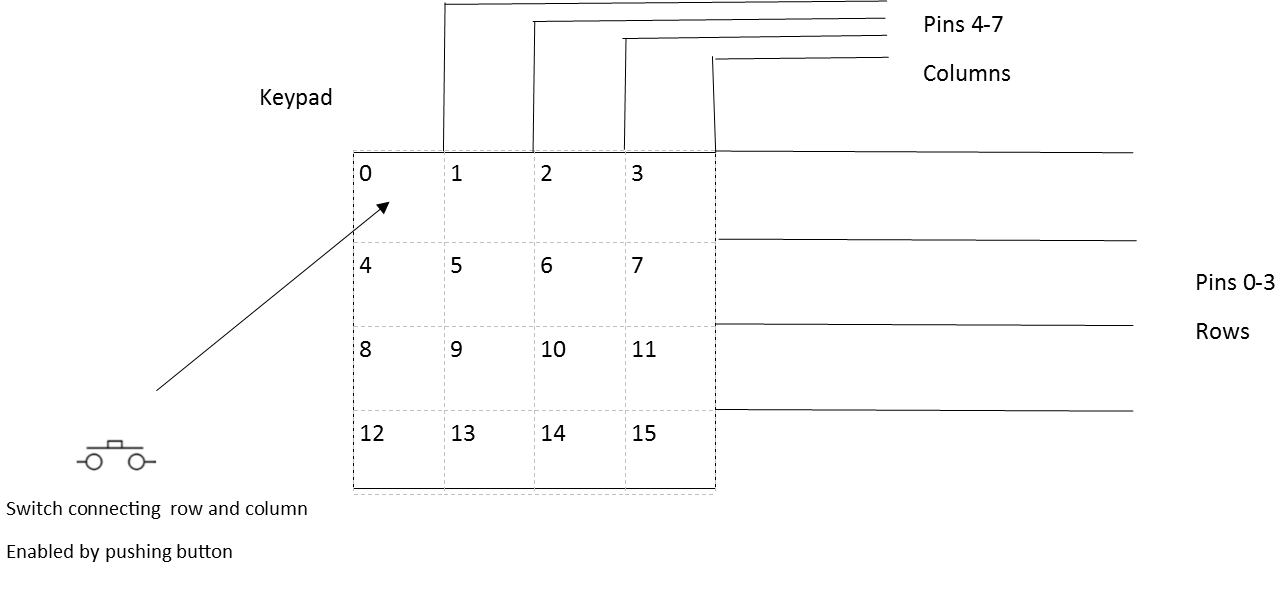
Report/Hardware/Keyboard/detailed keypad.png
