Nelsont345/Driver-Fingerprint-Scanner/Report/Hardware/Keyboard/expalined keypad image.png

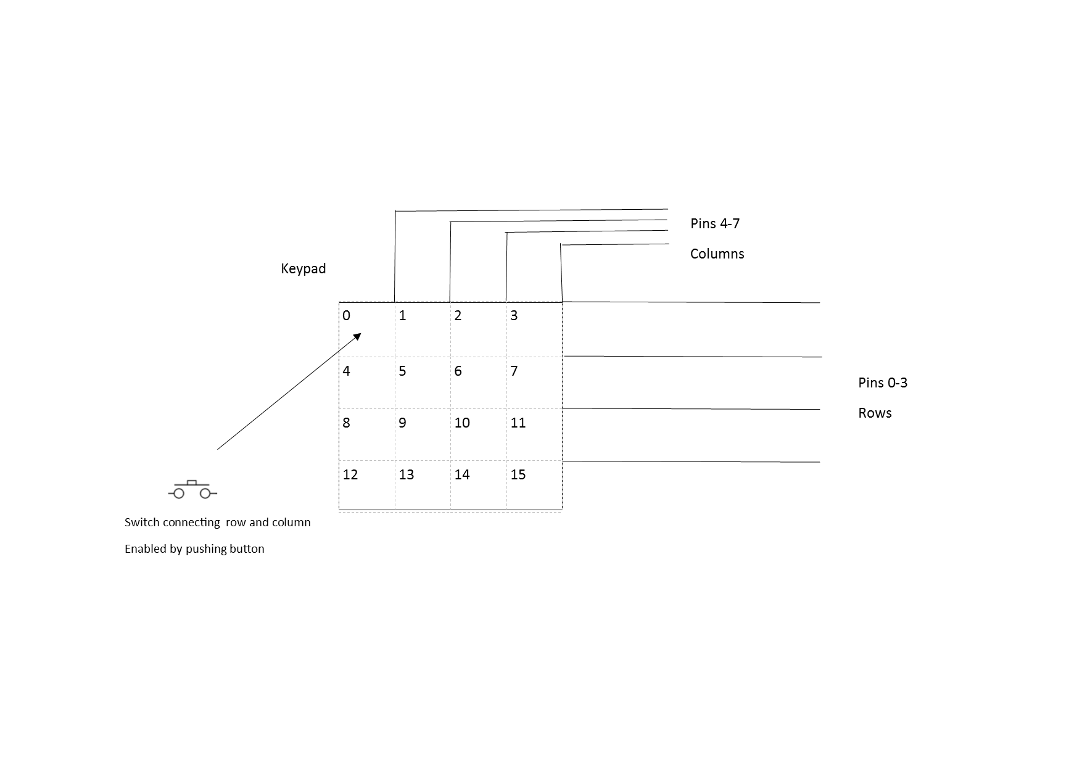
Report/Hardware/Keyboard/expalined keypad image.png
