Nelsont345/Driver-Fingerprint-Scanner/Report/Hardware/Processor/empty processor.png

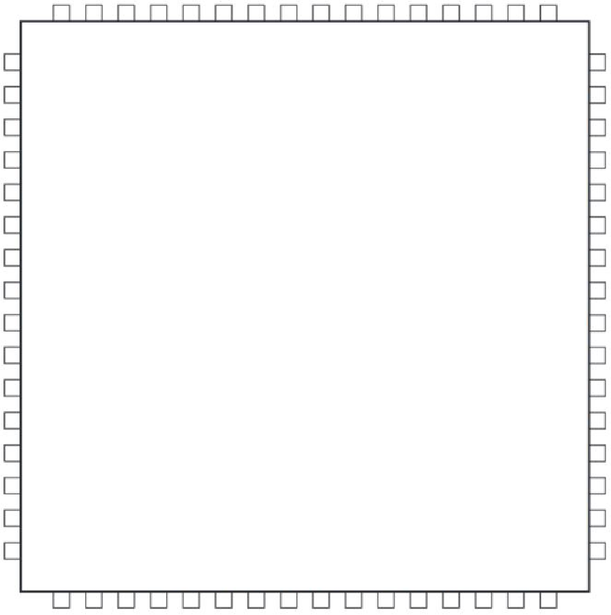
Report/Hardware/Processor/empty processor.png
