Nelsont345/Driver-Fingerprint-Scanner/Report/Hardware/Schematics/Actual Complete-Schematic.png

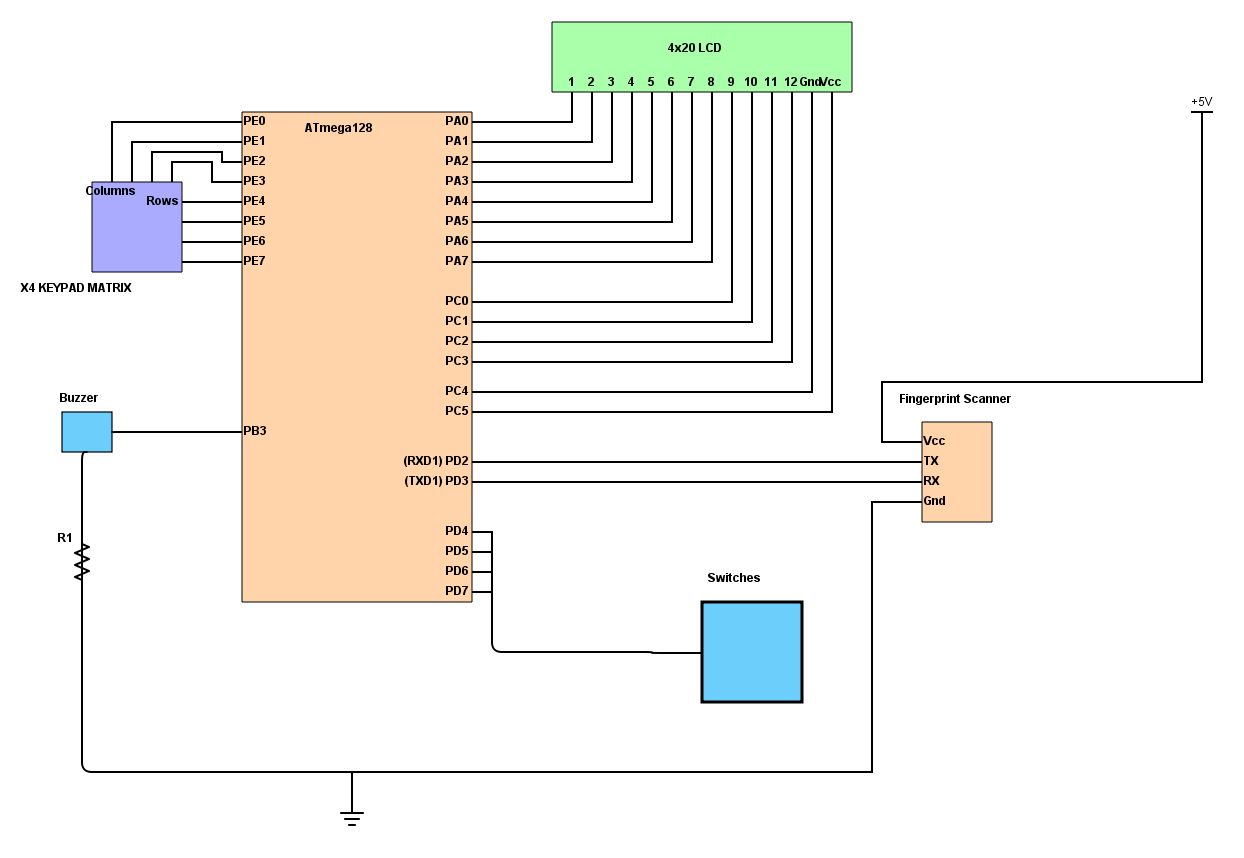
Report/Hardware/Schematics/Actual Complete-Schematic.png
