Nelsont345/Driver-Fingerprint-Scanner/Report/Hardware/Schematics/Actual Schematic.gif

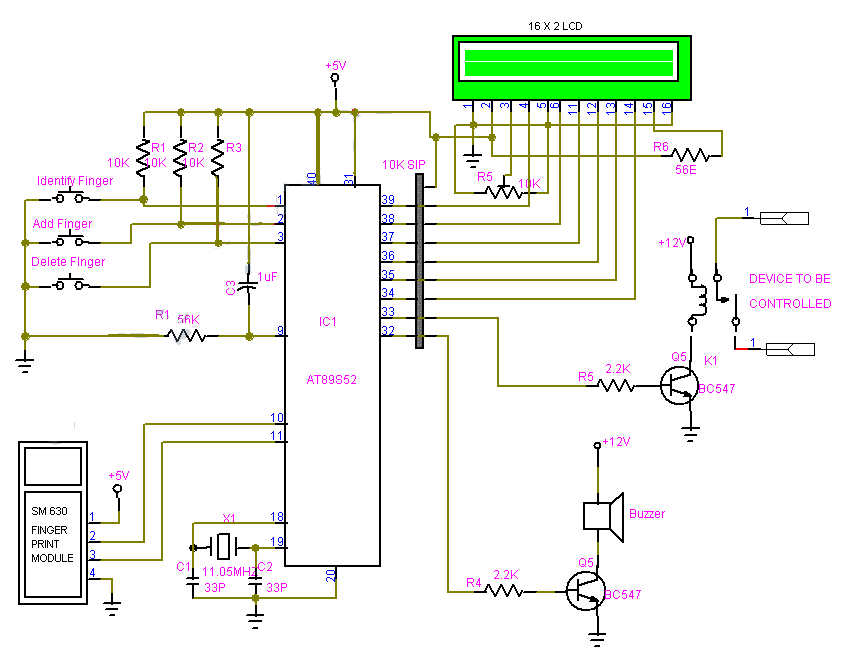
Report/Hardware/Schematics/Actual Schematic.gif
