Nelsont345/Driver-Fingerprint-Scanner/Report/Hardware/Schematics/Complete-Schematic2.png

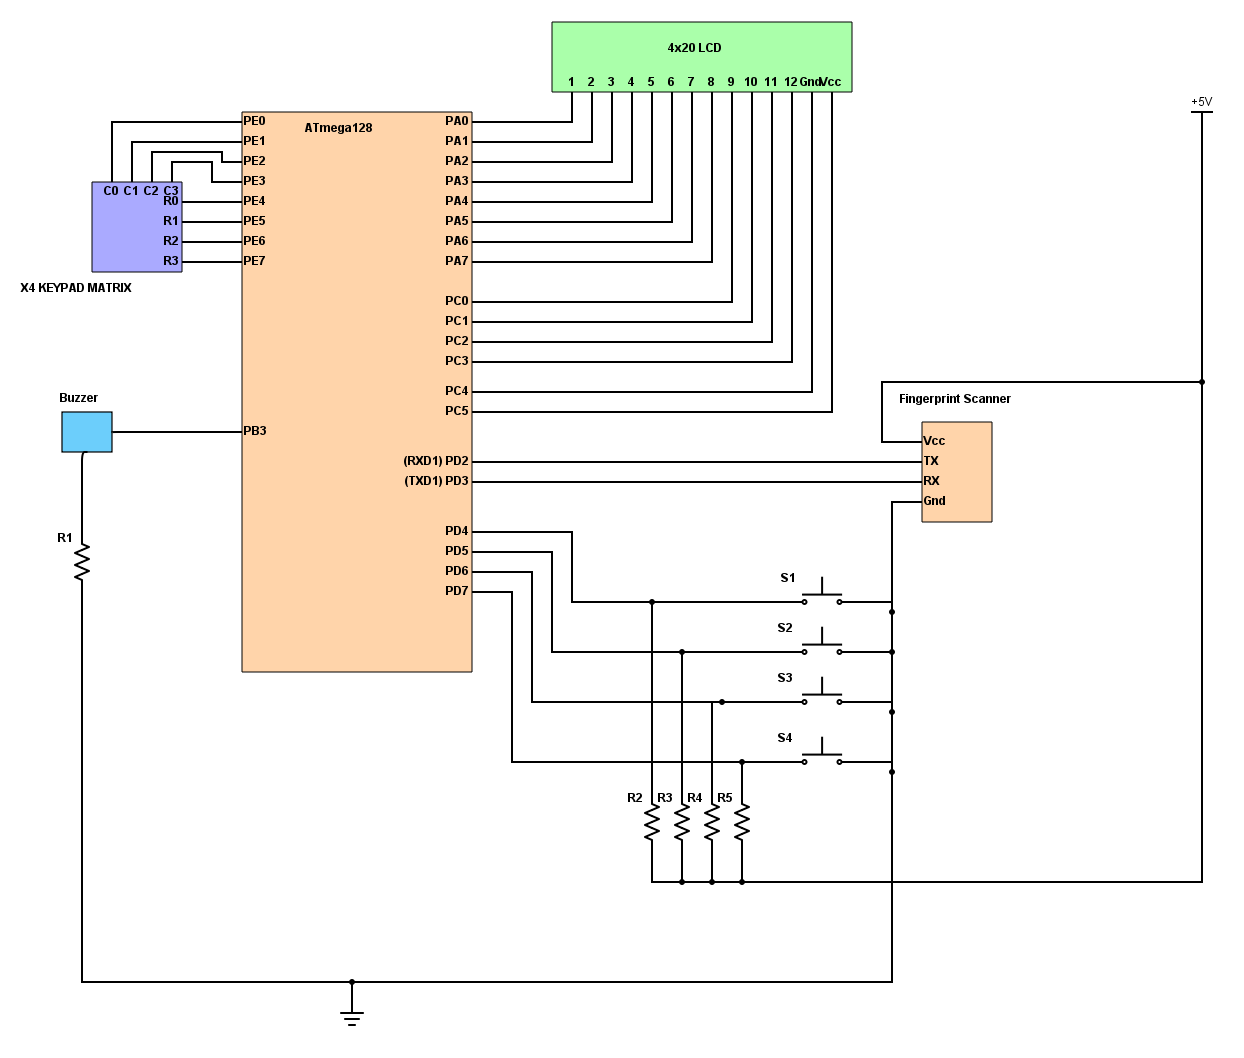
Report/Hardware/Schematics/Complete-Schematic2.png
