Nelsont345/Driver-Fingerprint-Scanner/Report/Hardware/Schematics/Detailed Schematic.png

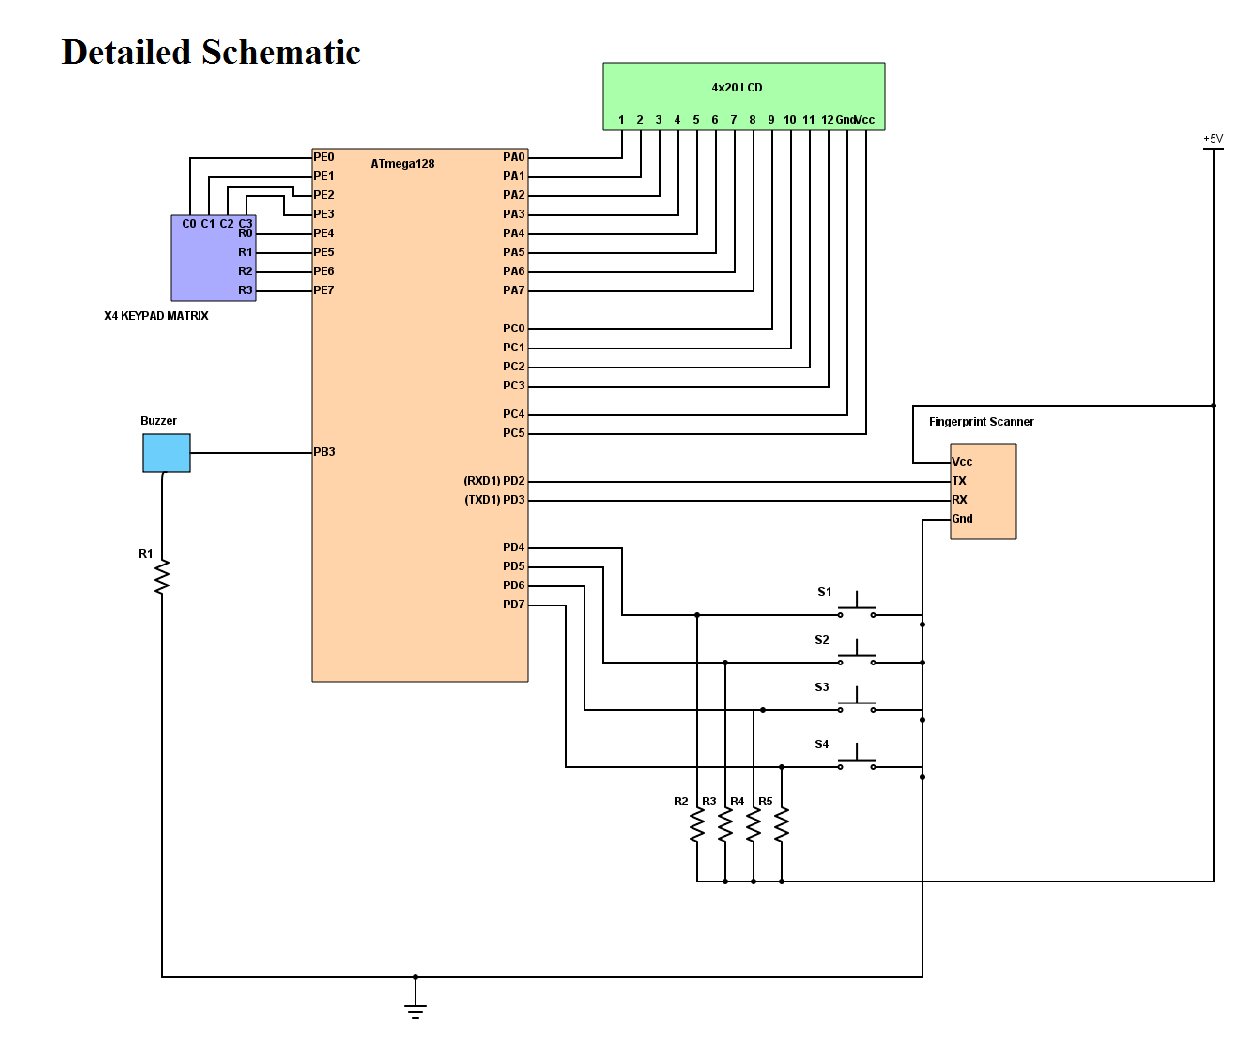
Report/Hardware/Schematics/Detailed Schematic.png
