Nelsont345/Driver-Fingerprint-Scanner/Report/Hardware/Schematics/Overall.png

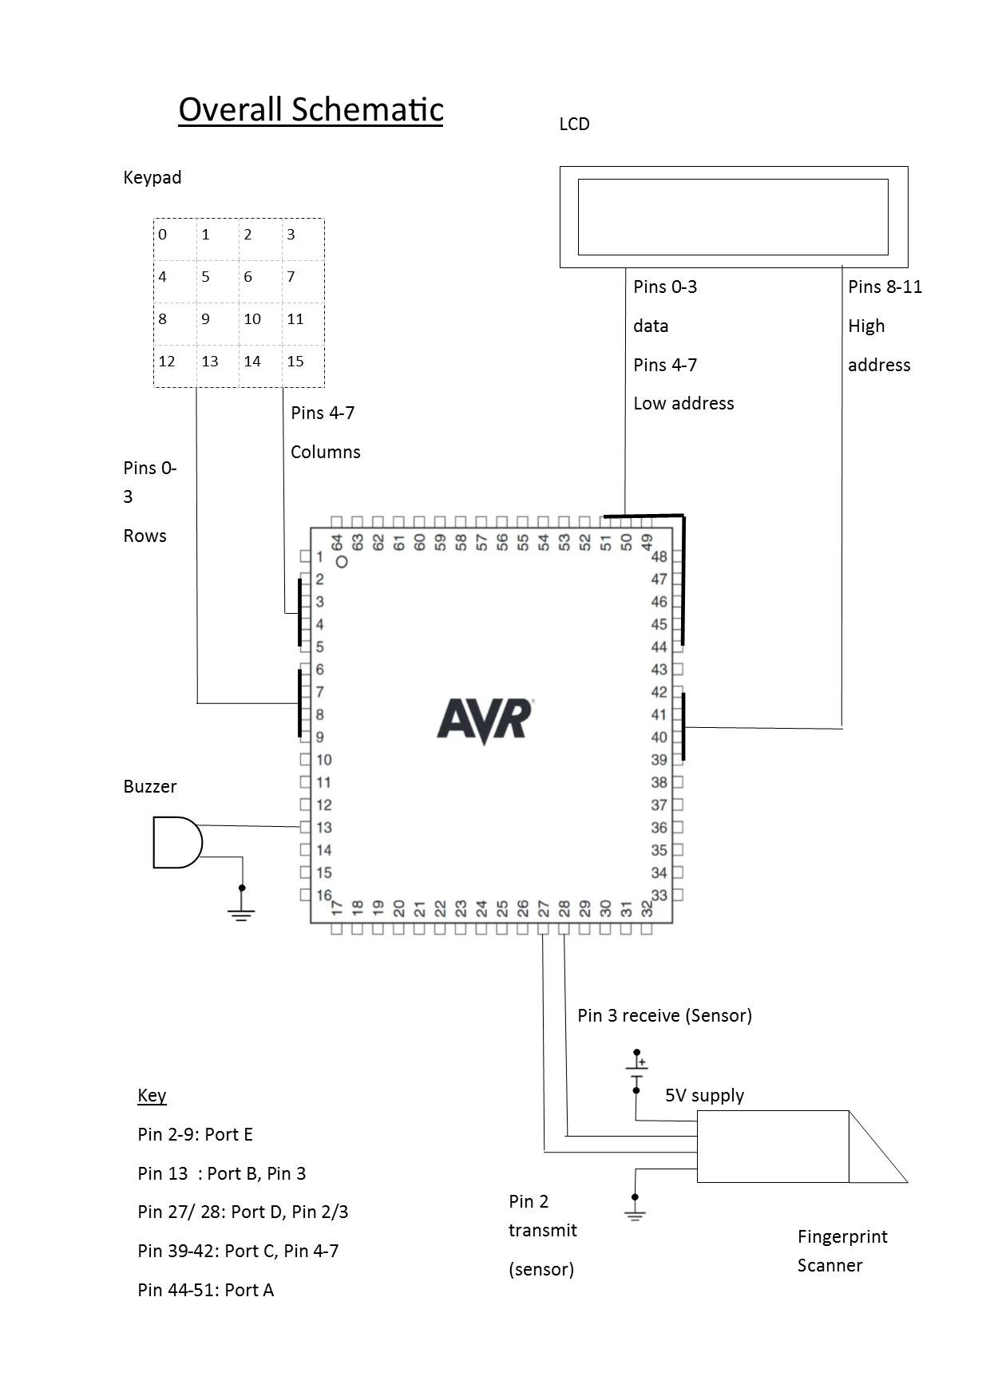
Report/Hardware/Schematics/Overall.png
