Nelsont345/Driver-Fingerprint-Scanner/Report/Hardware/Schematics/repeat/Complete-Schematic-7.png

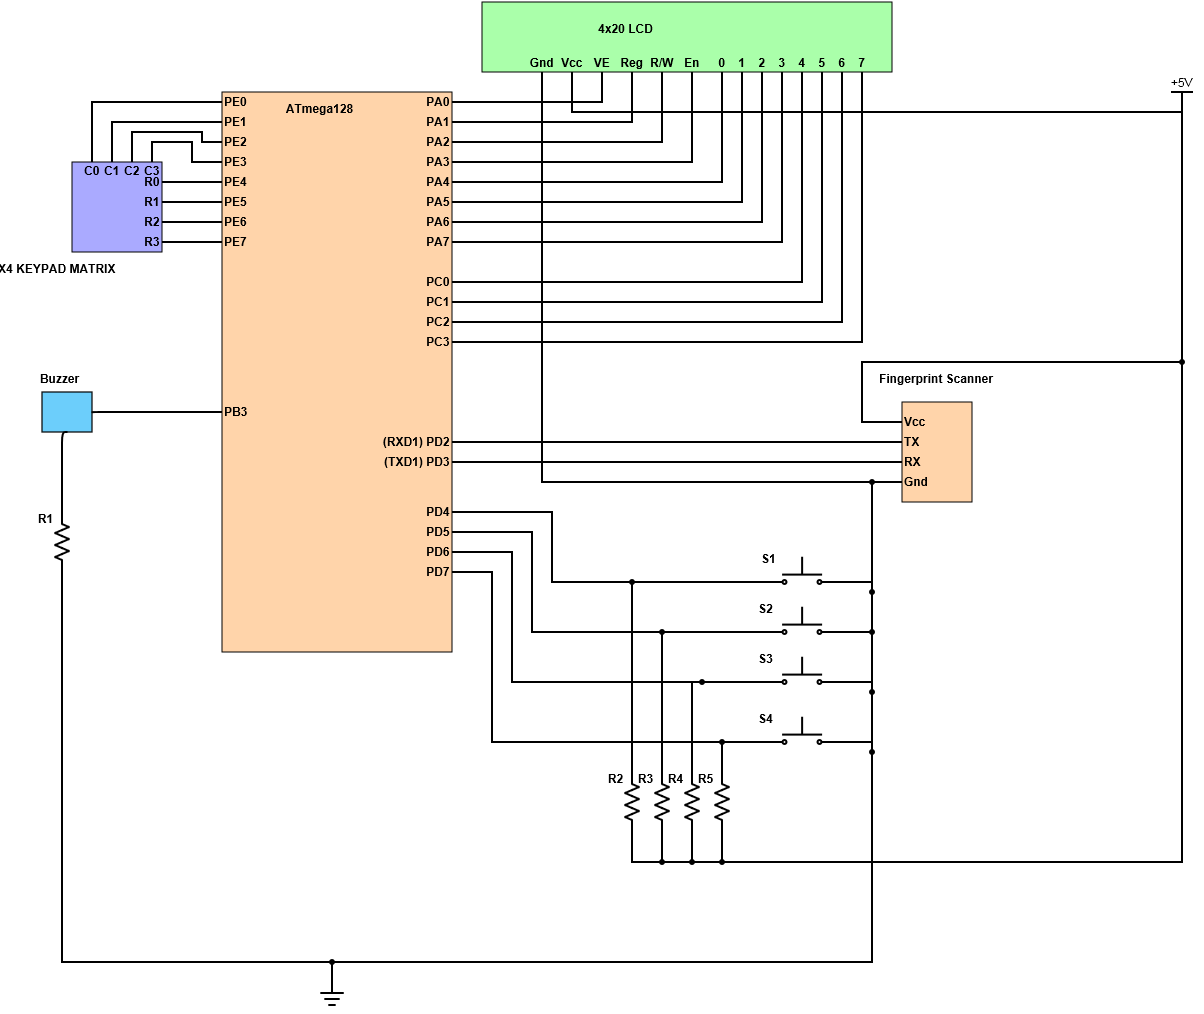
Report/Hardware/Schematics/repeat/Complete-Schematic-7.png
