Nelsont345/Driver-Fingerprint-Scanner/Report/Johan Markscheme.jpg

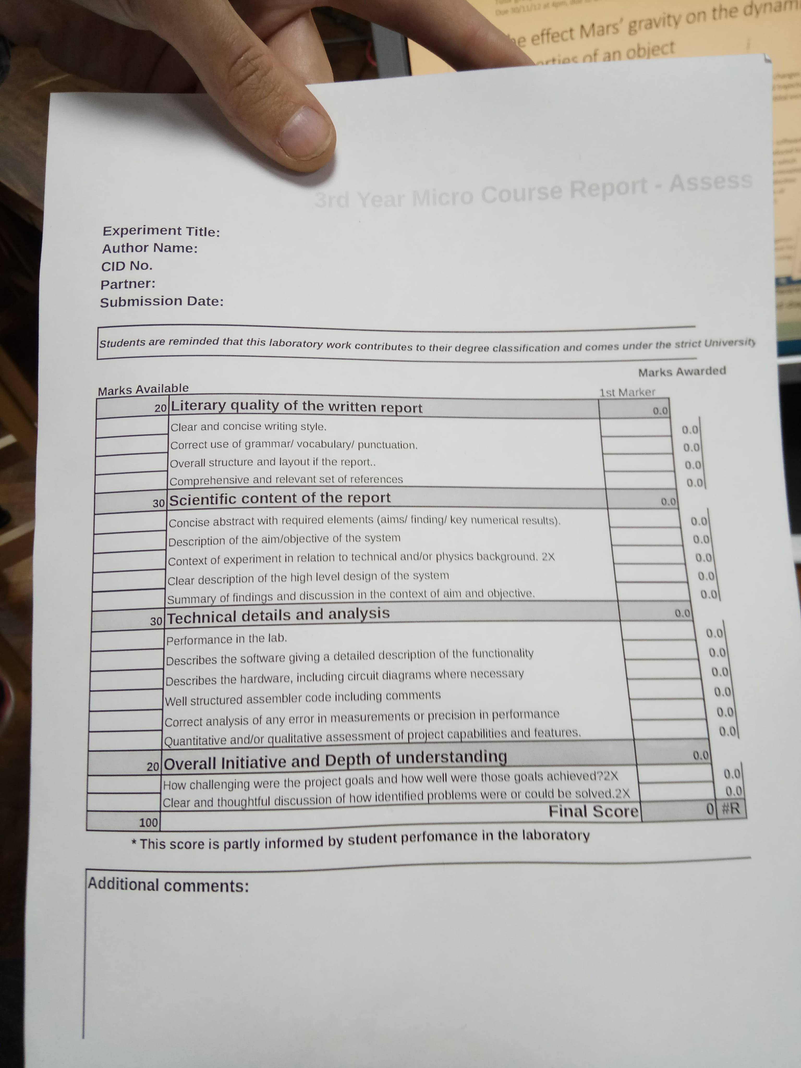
Report/Johan Markscheme.jpg
