Nelsont345/Driver-Fingerprint-Scanner/Report/mark scheme/1.JPG

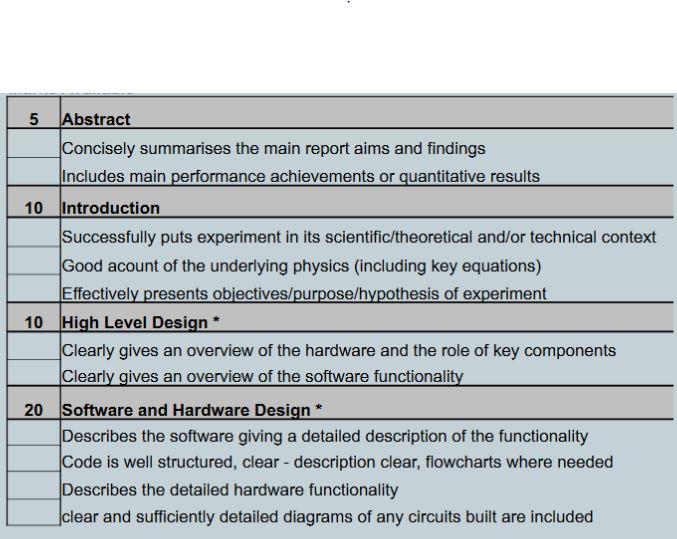
Report/mark scheme/1.JPG
