Nelsont345/Driver-Fingerprint-Scanner/Report/mark scheme/2.JPG

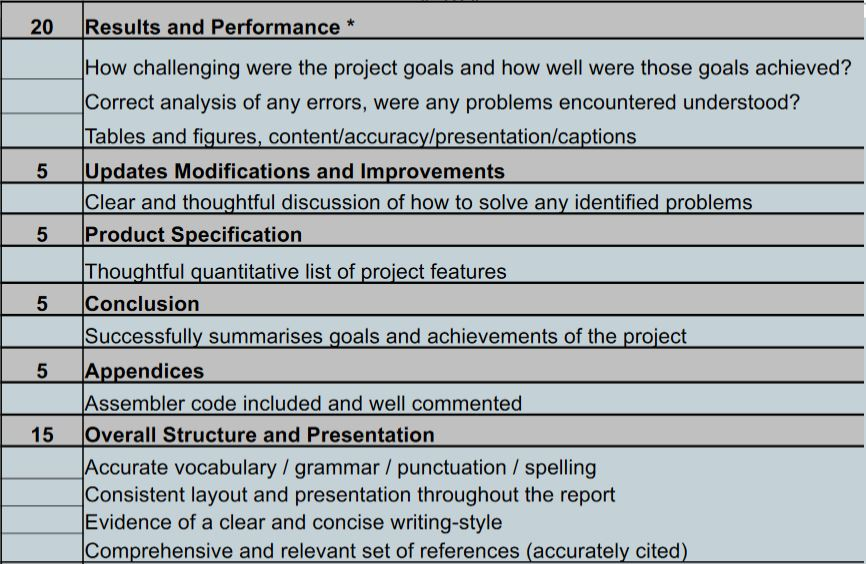
Report/mark scheme/2.JPG
