Nelsont345/Driver-Fingerprint-Scanner/Report/Overall Diagram, terrible.png

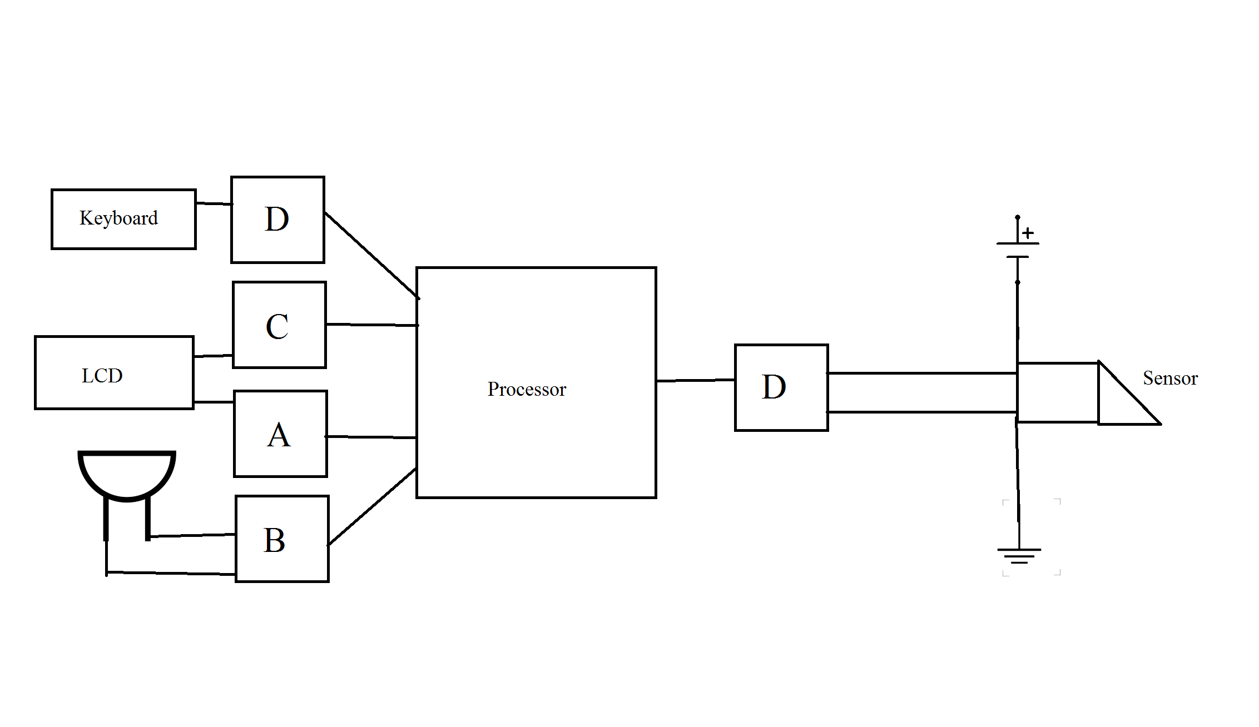
Report/Overall Diagram, terrible.png
