Nelsont345/Driver-Fingerprint-Scanner/Report/Screen Shots/1st_Screen.jpg

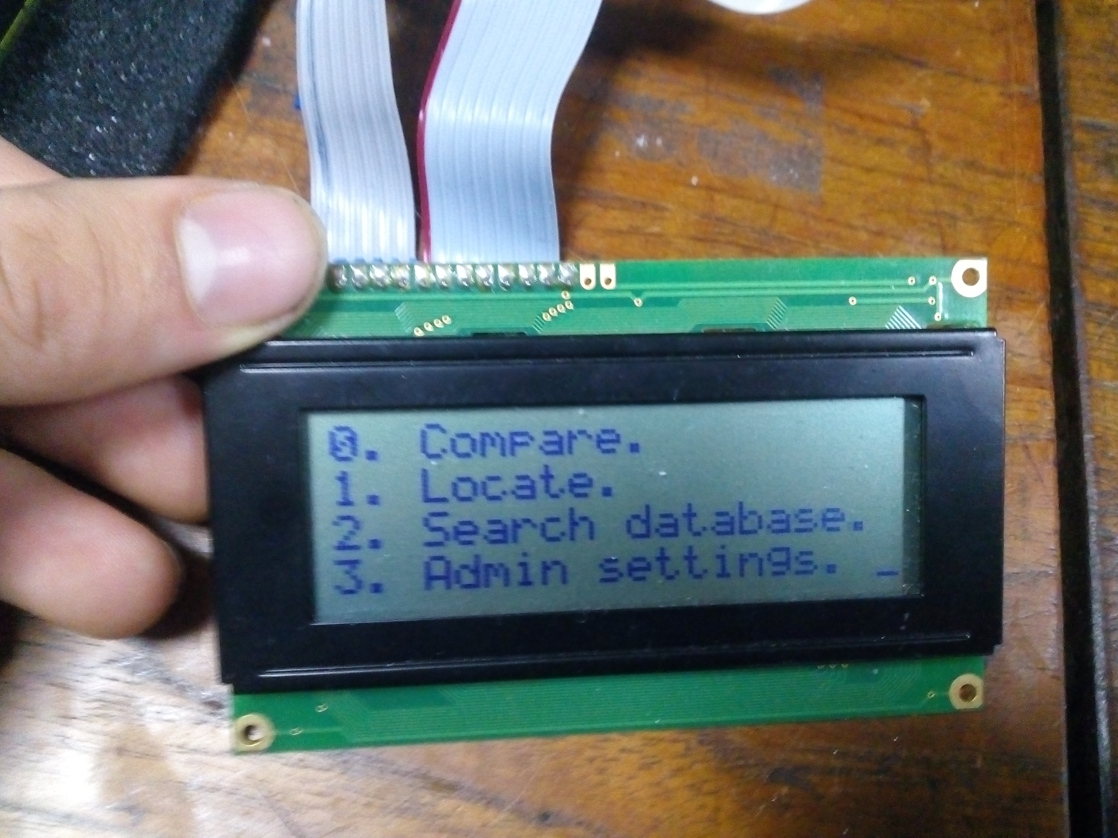
Report/Screen Shots/1st_Screen.jpg
