Nelsont345/Driver-Fingerprint-Scanner/Report/Screen Shots/2nd_Screen.jpg

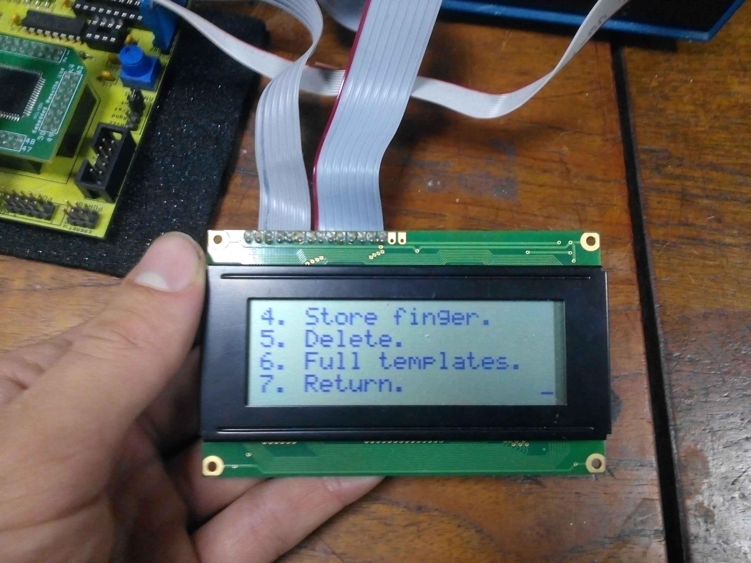
Report/Screen Shots/2nd_Screen.jpg
