Nelsont345/Driver-Fingerprint-Scanner/Report/Screen Shots/2nd_Screen.png

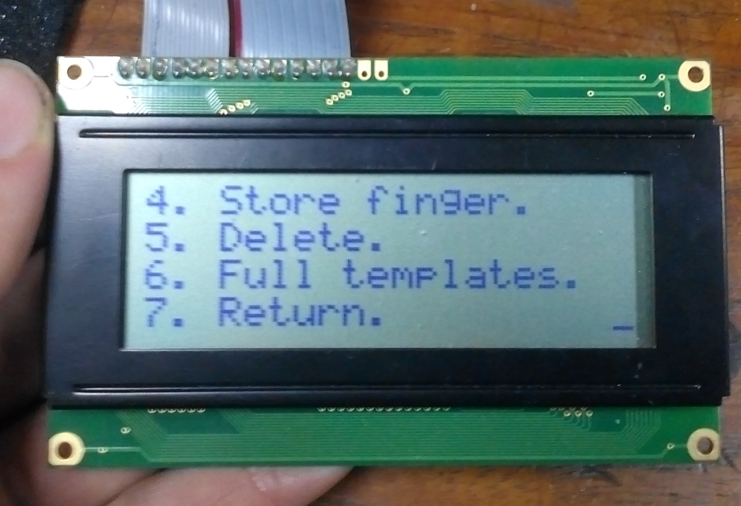
Report/Screen Shots/2nd_Screen.png
