Nelsont345/Driver-Fingerprint-Scanner/Report/Screen Shots/All.PNG

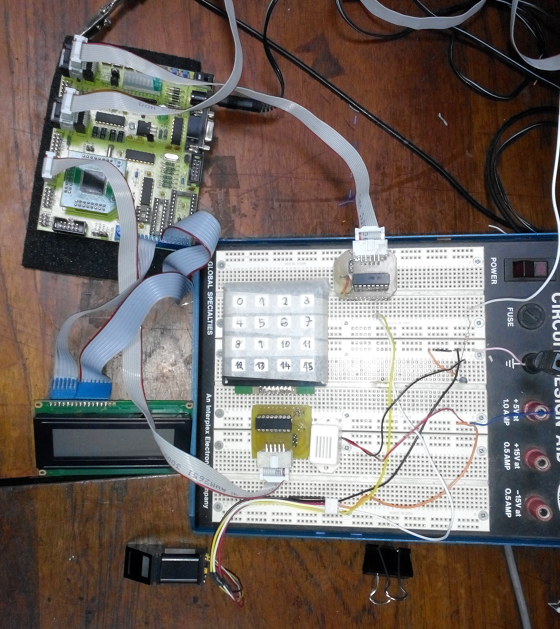
Report/Screen Shots/All.PNG
