Nelsont345/Driver-Fingerprint-Scanner/Report/Software/Flow charts/action4.png

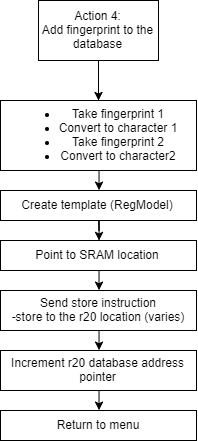
Report/Software/Flow charts/action4.png
