Nelsont345/Driver-Fingerprint-Scanner/Report/Software/Flow charts/action 1.png

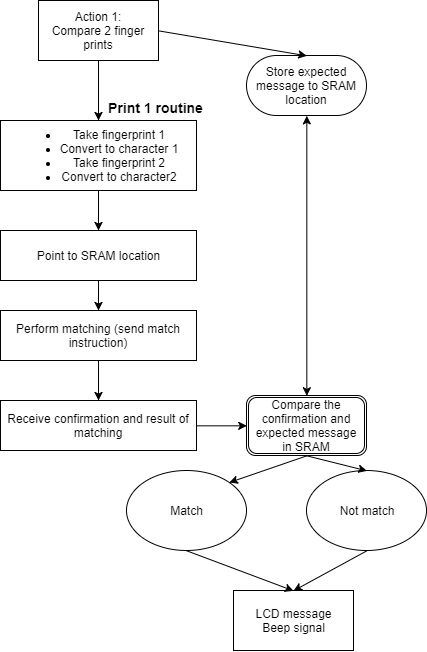
Report/Software/Flow charts/action 1.png
