Nelsont345/Driver-Fingerprint-Scanner/Report/Software/Flow charts/action 2.png

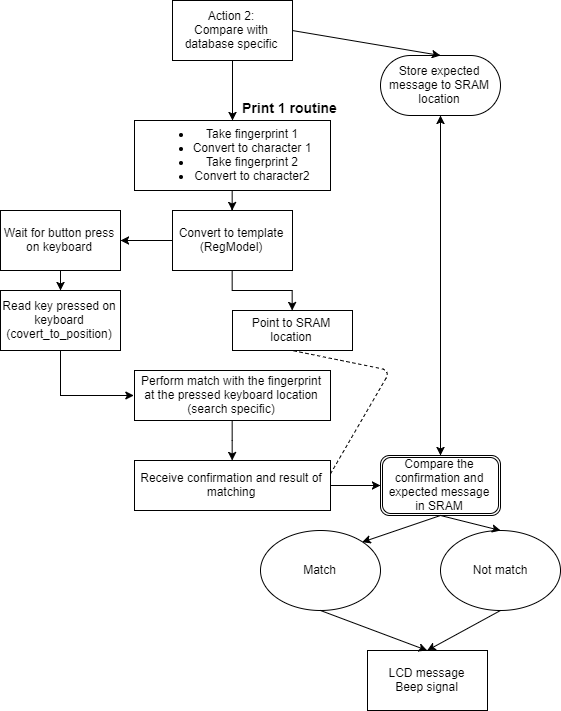
Report/Software/Flow charts/action 2.png
