Nelsont345/Driver-Fingerprint-Scanner/Report/Software/UART_send_byte.JPG

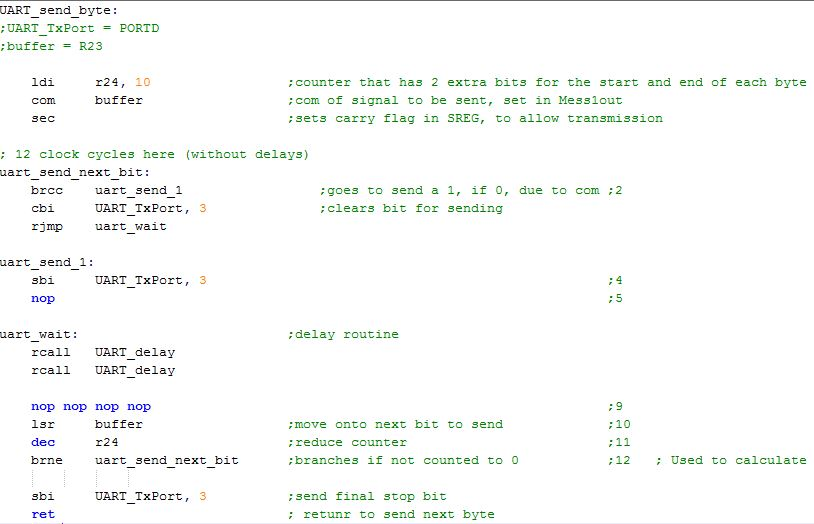
Report/Software/UART_send_byte.JPG
