Nelsont345/Driver-Fingerprint-Scanner/Report/Theory/FTIR.gif

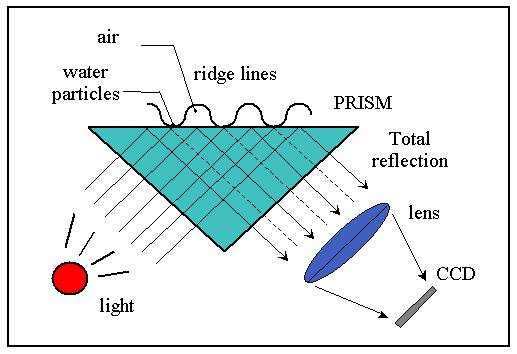
Report/Theory/FTIR.gif
