Nelsont345/Driver-Fingerprint-Scanner/ATmega32_ExploreUltraAvrDevKit-master/Hardware Design/Explore Ultra One base board/MCU_BaseBoard_BOM.xlsx

Id | Designator | Package | Quantity | Designation | Price
1 | D4 | LED-1206 | 1 | RL2 | 1
2 | D2 | LED-1206 | 1 | RL1 | 1
3 | D16,D3,D14,D13,D12,D11,D10,D9,D8,D7 | LED-1206 | 10 | LED | 10
4 | Q5,Q2,Q1,Q7,Q6,Q4,Q3 | sc70 | 7 | BC849 | 7
5 | SW20 | SPSPT_XL | 1 | SPST | 4
6 | LCD1 | WC1602A | 1 | LCD_2X16_SIL | 2
7 | U5 | 40pin_breakout | 1 | 40PIN_Breakout | 5
8 | D15 | Diode-SMA_Handsoldering | 1 | DIODE | 1
9 | D6,D5 | Diode-SMA_Handsoldering | 2 | 1N40XX | 1
10 | D17,D18,D19 | Diode-SMA_Handsoldering | 3 | ZENER | 1
11 | U7 | Pin_Header_Straight_1x20 | 1 | LCD-jhd12864e-xl | 3
12 | P18 | Pin_Header_Straight_1x06 | 1 | CONN_01X06 | 2
13 | C1 | c_elec_8x10.5 | 1 | 100uF, 25V | 4
14 | C2 | c_elec_8x10.5 | 1 | 100uF,25V | 4
15 | C3 | C_1206_HandSoldering | 1 | 0.1uf | 0.5
16 | C4 | C_1206_HandSoldering | 1 | 100nF | 0.5
17 | C5 | C_1206_HandSoldering | 1 | 10uF | 4
18 | IC1 | DIP-16__300_ELL | 1 | L293D | 4
19 | IC2 | SOT-223 | 1 | LM1117 | 6
20 | JP2,JP3 | bornier3 | 2 | M03-SCREW-5MM | 6
21 | JP4 | Pin_Header_Straight_1x08 | 1 | SWITCH_ARRAY | 2
22 | JP5 | Pin_Header_Straight_1x08 | 1 | MATRIX 4X4 | 2
23 | JP6 | Pin_Header_Straight_1x04 | 1 | MOTAR CNTRL | 2
24 | JP7 | Pin_Header_Straight_1x08 | 1 | led array | 2
25 | JP8,JP9 | bornier2 | 2 | m1 | 6
26 | K3 | Pin_Header_Straight_1x03 | 1 | I2C | 1
27 | K4 | BARREL_JACK | 1 | CONN_3 | 2.5
28 | P3,P4,P5,P25,P26,P27,P29,P19 | Pin_Header_Straight_1x04 | 8 | CONN_01X04 | 2
29 | P6,P7,P8,P9,P10,P15,P16 | 1pin | 7 | CONN_1 | 0
30 | P11 | Pin_Header_Straight_1x04 | 1 | CONN_4 | 1
31 | P12 | Pin_Header_Straight_1x08 | 1 | CONN_8 | 1
32 | P13 | Pin_Header_Straight_1x01 | 1 | CONN_1 | 1
33 | P22,P17 | Pin_Header_Straight_1x03 | 2 | CONN_01X03 | 1
34 | P28,P32 | Pin_Header_Straight_1x05 | 2 | CONN_01X05 | 1
35 | R1,R2,R17,R18,R26 | R_1206_HandSoldering | 5 | 10k | 1
36 | R3,R4,R5,R6,R7,R8,R9,R19 | R_1206_HandSoldering | 8 | 1K | 2
37 | R10 | R_1206_HandSoldering | 1 | 10K | 0.5
38 | R13 | R_1206_HandSoldering | 1 | 2.2k | 0.5
39 | R14 | R_1206_HandSoldering | 1 | 3.3k | 0.5
40 | R15 | R_1206_HandSoldering | 1 | 3.3K | 0.5
41 | R16,R27,R29,R30,R31,R32,R33,R34,R35 | R_1206_HandSoldering | 9 | 470 | 2
42 | R20,R28 | R_1206_HandSoldering | 2 | 33K | 0.2
43 | R21,R22,R23,R24 | R_1206_HandSoldering | 4 | 68 | 1
44 | RR1,RR2 | r_pack8 | 2 | RR8 | 2
45 | RV1 | Potentiometer_Triwood_RM-065 | 1 | TS | 2
46 | RV2 | Potentiometer_Triwood_RM-065 | 1 | POT | 45
47 | RV3,RV4 | Potentiometer_Triwood_RM-065 | 2 | VO | 2
48 | S1 | DIP-16__300_ELL | 1 | SW_DIP-8 | 7
49 | SD1 | Micro_SD | 1 | MICRO_SD | 10
50 | SG1 | Buzzer_12x9.5RM7.6 | 1 | BUZZERPTH | 7
51 | SW2 | SW_PUSH_SMALL_2pin_3D_xl | 1 | C | 1
52 | SW3 | SW_PUSH_SMALL_2pin_3D_xl | 1 | D | 1
53 | SW4 | SW_PUSH_SMALL_2pin_3D_xl | 1 | E | 1
54 | SW5 | SW_PUSH_SMALL_2pin_3D_xl | 1 | F | 1
55 | SW6 | SW_PUSH_SMALL_2pin_3D_xl | 1 | 9 | 1
56 | SW7 | SW_PUSH_SMALL_2pin_3D_xl | 1 | 0 | 1
57 | SW8 | SW_PUSH_SMALL_2pin_3D_xl | 1 | A | 1
58 | SW9 | SW_PUSH_SMALL_2pin_3D_xl | 1 | B | 1
59 | SW10 | SW_PUSH_SMALL_2pin_3D_xl | 1 | 5 | 1
60 | SW11 | SW_PUSH_SMALL_2pin_3D_xl | 1 | 6 | 1
61 | SW12 | SW_PUSH_SMALL_2pin_3D_xl | 1 | 7 | 1
62 | SW13 | SW_PUSH_SMALL_2pin_3D_xl | 1 | 8 | 1
63 | SW14 | SW_PUSH_SMALL_2pin_3D_xl | 1 | 1 | 1
64 | SW15 | SW_PUSH_SMALL_2pin_3D_xl | 1 | 2 | 1
65 | SW16 | SW_PUSH_SMALL_2pin_3D_xl | 1 | 3 | 1
66 | SW17 | SW_PUSH_SMALL_2pin_3D_xl | 1 | 4 | 1
67 | SW18 | SW_PUSH_SMALL_2pin_3D_xl | 1 | INT0 | 1
68 | SW19 | SW_PUSH_SMALL_2pin_3D_xl | 1 | INT1 | 1
69 | U2 | DIP-8__300_ELL | 1 | 24C16 | 1
70 | U3 | DIP-8__300_ELL | 1 | DS1307 | 1
71 | U4 | BATT_rtc_XL | 1 | BATTERY | 4
72 | JP1 | Pin_Header_Straight_1x02 | 1 | RELAY | 0.5
73 | JP10 | Pin_Header_Straight_1x02 | 1 | JUMPER | 0.5
74 | K1,K2 | XL-RELAY-12 | 2 | RELAYPTH | 16
75 | U1 | LM78XX_v1_XL1 | 1 | 7805 | 5
76 | R25 | Pin_Header_Straight_1x02 | 1 | LDR | 3.5
77 | P30 | Pin_Header_Straight_1x07 | 1 | CONN_01X07 | 2
78 | P31 | Pin_Header_Straight_1x08 | 1 | CONN_01X08 | 2
79 | P1 | Pin_Header_Straight_1x02 | 1 | CONN_01X02 | 2
80 | AFF2,AFF3,AFF4,AFF1 | 7SegmentLED_LTS6760_LTS6780 | 4 | LTS-6960HR | 3
81 | P2,P14 | Pin_Header_Straight_1x20 | 2 | CONN_01X20 | 2
82 | X1 | RTC_Crystal | 1 | CRYSTAL_SMD | 3
83 | EE_LOGO,EE_LOGO | EE_LOGO(2) | 2 |  | 238.2
 |  |  |  |  |  | Explore One base board
 |  |  |  | Heatsink | 3.5 | 238
 |  |  |  | L293D | 37 | 3.5
 |  |  |  | 7Segment | 16 | 37
 |  |  |  | DS1307 | 22 | 16
 |  |  |  | EEPROM | 17 | 22
 |  |  |  | CR2032 | 6 | 17
 |  |  |  | 12v,1A Adaptor | 70 | 6
 |  |  |  | USB cable AtoB | 30
 |  |  |  | USB Micro | 30
 |  |  |  | LCD | 130
 |  |  |  | DVD | 10 | 130
 |  |  |  | Packing | 25 | 10
 |  |  |  | 6 pin cable | 15 | 25
 |  |  |  | Screws | 25
 |  |  |  | PCB | 212 | 25
 |  |  |  | Solder | 150 | 212
 |  |  |  |  | 798.5 | 150
 |  |  |  | USB Shield | 130 | 130
 |  |  |  | Break out | 270 | 1021.5
 |  |  |  | Programmer | 0 | 2
 |  |  |  |  |  | 2043
 |  |  |  |  | 1436.7
 |  |  |  |  | 2873.4
