Nelsont345/Driver-Fingerprint-Scanner/(list of files, cad)

Other CAD files:
ATmega32_ExploreUltraAvrDevKit-master/Hardware Design/Explore Ultra One base board/MCU_BaseBoard-drl_map.dxf
ATmega32_ExploreUltraAvrDevKit-master/Hardware Design/Explore Ultra One base board/MCU_BaseBoard-NPTH-drl_map.dxf
