Nelsont345/Driver-Fingerprint-Scanner/Report/Experiment/New Results.xlsx

Finger | Successful results ou of 30) | t
Thumb | 9 |  | 90
Index | 8 |  | 80
Third | 9 |  | 90
Fourth | 7 |  | 70
Fifth | 6 |  | 60
Finger | Accuracy
Thumb | 90
Index | 80
Third | 90
Fourth | 70
Fifth | 60
