Nelsont345/Driver-Fingerprint-Scanner/Report/Software/testregisters.PNG

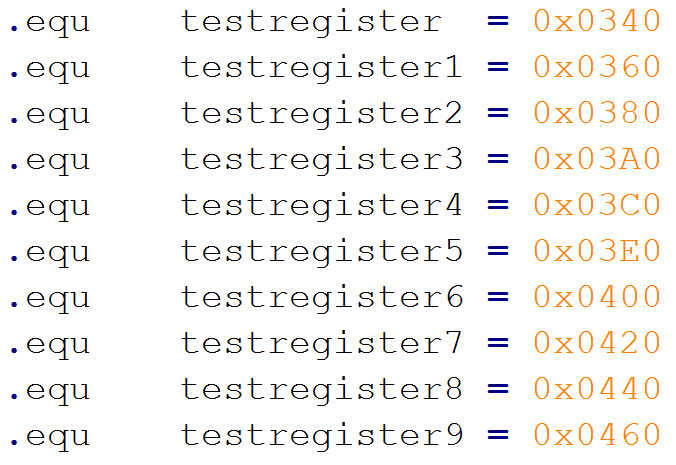
Report/Software/testregisters.PNG
