Nelsont345/Driver-Fingerprint-Scanner/(list of files, drawings)

Other design files:
ATmega32_ExploreUltraAvrDevKit-master/Others/Fritzing images/10b-Keypad_LCD.fzz
ATmega32_ExploreUltraAvrDevKit-master/Others/Fritzing images/Controlling AC device using Relay_AVR.fzz
ATmega32_ExploreUltraAvrDevKit-master/Others/Fritzing images/EXT_Interrupt_Edge_Level.fzz
ATmega32_ExploreUltraAvrDevKit-master/Others/Fritzing images/Interfacing KS0108 based JHD12864E Graphics LCD with Atmega32 .fzz
ATmega32_ExploreUltraAvrDevKit-master/Others/Fritzing images/Interfacing Seven Segment Displays with AVR.fzz
ATmega32_ExploreUltraAvrDevKit-master/Others/Fritzing images/LCD 16X2_AVR.fzz
ATmega32_ExploreUltraAvrDevKit-master/Others/Fritzing images/Reading Temperature with AVR ADC.fzz
ATmega32_ExploreUltraAvrDevKit-master/Others/Fritzing images/Reading Temperature with AVR ADC_TEMP.fzz
ATmega32_ExploreUltraAvrDevKit-master/Others/Fritzing images/Real Time Clock(DS1307) with AVR_LCD.fzz
