Nelsont345/Driver-Fingerprint-Scanner/Report/Software/Snippets/final Final Main.asm

; AssemblerApplication3.asm
;
; Created: 03/11/2017 16:31:37
; Authors : Nelson Talukder and Tomas Jirman
;


	.DEVICE ATmega128
	.include "m128def.inc"


;""""""""""""""""""""""""""""""""""""""""""""""""""""""""""""""""""""""""""""""""
	jmp Init							
	; INTERUPT:
	.org		$003c					
	rjmp save_data_start352				; UART Receive  Vector 					
	.org		$0080					; start address above interrupt table

;""""""""""""""""""""""""""""""""""""""""""""""""""""""""""""""""""""""""""""""""
.include "action4include.asm"
init:									; system init routine

	;renaming pins
	.equ	UART_TxPort = PORTD			;set port D aS OUTPUT FOR TRANSMIT
	.equ	UART_TxDDR  = DDRD			;DIRECTION REGISTER

	;Locations in SRAM that are used in the programme
	.equ	compare_address = 0x0300	;DATABASE to SRAM, saves to here
	.equ	savedregister = 0x0320      
	.equ	testregister  = 0x0340           ;all used in interrupt
	.equ	testregister1 = 0x0360
	.equ    testregister2 = 0x0380
	.equ    testregister3 = 0x03A0      
	.equ    testregister4 = 0x03C0
	.equ    testregister5 = 0x03E0
	.equ    testregister6 = 0x0400
	.equ    testregister7 = 0x0420
	.equ    testregister8 = 0x0440 
	.equ	testregister9 = 0x0460 

	.def	buffer = R23			

										;Speed setting  
	.equ	FREQ = 8000000   
	.equ	BAUD = 57600  

	.dseg
	DELAY_VALUE: .byte 1				;assign memory for clock speed value
	.cseg

	.equ	r = 18						;divison by 3 of d, definition


; ************************* MEMORY ERRASER **************************************
; It is crucial for the operation of device to start with clear memory where
;data is stored as responce from the finger print scanner.

									; erases memory from 0x0300 to 0x0900
eraser:
	ldi XH, high(compare_address)
	ldi XL, low(compare_address)
loop:
	push r20
	ldi r20, $01
	st X+, r20
	cpi XH, $09
	brne loop
	pop r20

;######################### PORT SET UPS #########################################


	ldi r16, $FF					;Set-up Port B as Output
	out DDRB , r16		
	ldi r16, 00		
	out PORTB, r16		


	ldi r16, $0F					; Stack Pointer Setup
	out SPH,r16						; Stack Pointer High Byte 
	ldi r16, $FF					; Stack Pointer Setup 
	out SPL,r16						; Stack Pointer Low Byte 

	; ******* RAMPZ Setup Code ****  lower memory page arithmetic
	ldi  r16, $00					; 1 = EPLM acts on upper 64K
	out RAMPZ, r16					; 0 = EPLM acts on lower 64K


	; ******* Enable External SRAM i.e the LCD  *******
	ldi r16, $C0					; Set 11000000, i.e enable read/write 							
	out MCUCR, r16					; External SRAM Enable Wait State Enabled
   
	; ******* Comparator Setup Code ****  
	ldi r16,$80						; Comparator Disabled, Input Capture Disabled 
	out ACSR, r16					; Comparator Settings


;######################### USART SET UP #########################################
	ldi r16, (1<<RXEN1)|(1<<RXCIE1)   ;enables interrupt
	sts UCSR1B,r16
; Set frame format: 8data, 2stop bit
	ldi r16, (1<<USBS1)|(3<<UCSZ10)
	sts UCSR1C,r16
	push r16
	push r17
	ldi r16, $08
	ldi r17, $00
	sts UBRR1H, r17
	sts UBRR1L, r16
	pop r17
	pop r16

	ldi YH, high(testregister)
	ldi YL, low(testregister)
	sei
	
;(((((((((((((((((((((((((((((((())))))))))))))))))))))))))))))))))))))))))))))))
	rjmp main
;(((((((((((((((((((((((((((((((())))))))))))))))))))))))))))))))))))))))))))))))


;____________________ DATABASE OF MESSAGES AND COMMANDS TO THE SCANNER___________
ReadSysPara:
	.db $EF,$01,$FF,$FF,$FF,$FF,$01,$00,$03,$0f, $00, $13
;========================== Admin Settings ====================================== 
TempleteNum:
	.db $EF,$01,$FF,$FF,$FF,$FF,$01,$00,$03,$1d, $00, $21    ;no of templates
DeleteChar:
	.db $EF,$01,$FF,$FF,$FF,$FF,$01,$00,$07,$0C, $00, $00, $00, $0F, $00, $23    
;================================================================================

genimg:
	.db $EF,$01,$FF,$FF,$FF,$FF,$01,$00,$03,$01, $00, $05,$08,$00

img2tBuff1:
	.db $EF,$01,$FF,$FF,$FF,$FF,$01,$00,$04,$02,$1,$00,$08,$0

img2tBuff2:
	.db $EF,$01,$FF,$FF,$FF,$FF,$01,$00,$04,$02,$2,$00,$09,$0

regmodel:
	.db $EF,$01,$FF,$FF,$FF,$FF,$01,$00,$03,$05,$00,$09    

Store4:
	.db $EF,$01,$FF,$FF,$FF,$FF,$01,$00,$06,$06,$01, $00 

PreciseMatch:
	.db $EF,$01,$FF,$FF,$FF,$FF,$01,$00,$03,$03, $00, $07,$08,$00  

Search:
	.db $EF,$01,$FF,$FF,$FF,$FF,$01,$00,$08,$04, $01, $00,$00 ,$00, $46, $00, $54, $00

search2:
	.db $EF,$01,$FF,$FF,$FF,$FF,$01,$00,$08,$04,$01   




;&&&&&&&&&&&&&&&&&&&&&&&&&&&&Compare DATABASE&&&&&&&&&&&&&&&&&&&&&&&&&&&&&&&&&&&&

compare_database:

	.db $EF, $01, $FF, $FF, $FF, $FF, $07,$00, $05, $00, $00, $0A  ;Used in datbase_to_SRAM

compare_database2:
	.db $EF, $01, $FF, $FF, $FF, $FF, $07,$00, $07, $00, $00, $0A  ;Used in datbase_to_SRAM4

;££££££££££££££££££££££££ LCD DATABASE ££££££££££££££££££££££££££££££££££££££££££

Match:
	.db ' ','M', 'a', 't' ,'c', 'h'       

Different:
	.db ' ', 'D','i','f','f','e','r','e','n','t'

Tomas:
	.db "  Tomas"

Nelson:
	.db "  Nelson"

George:
.db "  George"

Welcome:
	.db " Welcome! Press Pins 0 to 3 to start."

Welcomemessage1:
	.db " 0. Compare.         2. Search database. 1. Locate.          3. Admin settings. "

Welcomemessage2:
	.db " 4. Store finger.    6. Full templates.  5. Delete.          7. Return.         "

ready:
	.db "  Enter ID number: "
	

ID_recognised:
	.db "  Access granted.  "

;££££££££££££££££££££££££££££££££££££££££££££££££££££££££££££££££££££££££££££££££


;*****                UART DELAY                *****
; 3*b + const_delay_cycles
UART_delay:	
	lds		r16, DELAY_VALUE
	
	
UART_delay1:	
	dec		r16
	brne	UART_delay1
	nop
	ret

uart_init:							; initiation of SW UART
	in		r16, UART_TxDDR
	ori		r16, (1<<3)				;set pin 3 as ouput
	out		UART_TxDDR, r16
	sbi		UART_TxPort, 3
	
	ldi		r16, r					;really important helps get
	sts		DELAY_VALUE, r16		; correct No. of Cycles for frequency
	ret

	ldi r16, $01
	ret
;********************************************************************************
;********************************************************************************














;**************************  MAIN ***********************************************
;********************************************************************************
;********************************************************************************


main:								;RUNS ONCE HERE - THis is basically init2 which runs just once
    rcall Idisp
	rcall uart_init
	rcall CLRDIS
	rcall beepon

	rcall Welcome2					; first welcoming message
	rcall bigdel
	rcall bigdel
	rcall bigdel
	rcall CLRDIS
	
LDI r25, $02						; start dsavinbg 03 -> this points to starting address in scanner


main2:								; this is the main loop -> menu 1 with normal user functions
	rcall clear750					;clears SRAM location, used to store Admin Verification result
	rcall Welcome3
	rcall waitforbuttonpress
	rcall CLRDIS
	rjmp main2


;********************************************************************************
;********************************************************************************
;********************************************************************************


clear750: 							; clears SRAM locaiton used for tests
	push r16
	ldi r16, 0
	sts 0x0750, r16
	pop r16
	ret
	

;GGGGGGGGGGGGGGGGGGGGGGG Welcome Messages GGGGGGGGGGGGGGGGGGGGGGGGGGGGGGGGGGGGGGG
; the logic of the messages is to load SRAM address of the welcome message to Z and
;then start displaying one by one characted in LCD routines => Mess1More2
	
Welcome2:							;First Screen wth instructions selecting options
	LDI ZH, HIGH(2*Welcome)			
    LDI ZL, LOW(2*Welcome)
    LDI r18, 37						;number of characters or bytes
	rcall Mess1More22
	ret

Welcome3:							;First Screen with non Admin Options
	rcall clrdis
	LDI ZH, HIGH(2*Welcomemessage1)
    LDI ZL, LOW(2*Welcomemessage1)
    LDI r18, 80						
	rcall Mess1More22
	rcall bigdel
	ret

Welcome5:							;Second Screen with Admin Options
	rcall clrdis
	LDI ZH, HIGH(2*Welcomemessage2)
    LDI ZL, LOW(2*Welcomemessage2)
    LDI r18, 80						
	rcall Mess1More22
	rcall bigdel
	ret

READY2:								;Asking for Keypad Input
	rcall clrdis
	LDI ZH, HIGH(2*ready)
    LDI ZL, LOW(2*ready)
    LDI r18, 19						
	rcall Mess1More22
	rcall bigdel
	ret


message_ID_recognised:				;'Access Granted'
	rcall clrdis
	LDI ZH, HIGH(2*ID_recognised)
    LDI ZL, LOW(2*ID_recognised)
    LDI r18, 19						
	rcall Mess1More22
	rcall bigdel
	ret

;XXXXXXXXXXXXXXXXXXXXXXXXXXXXXXX  Beginning OF RETURN    XXXXXXXXXXXXXXXXXXXXXXXX
;XXXXXXXXXXXXXXXXXXXXXXXXXXXXXXX  Beginning OF RETURN    XXXXXXXXXXXXXXXXXXXXXXXX


 ;*********************************COMPARING2************************************

; in this routine we are going to compare 2 sram databases
; this is crucial routine for decitions about fullfillment of conditions and sucesses 
; of finger print detections
compare_basic2:

	push r17
	push r20
	push r21
	push r18
	ldi r18,  0						;counter
	rcall Comp1Out2Z
	rcall Comp1Out2Y
	rjmp Comp1More2


Comp1Out2Z:							;the one we compare to

	LDI ZH, HIGH(compare_address)   ;address for comparison 
    LDI ZL, LOW(compare_address)
	ret
Comp1Out2Y:
	ldi YL, low(testregister5)      ;saved Acknowledgement Package
	ldi YH, high(testregister5) 
	ret
  
			   
Comp1More2:
	ld r20, Z+
	ld r17, Y+

	inc r18
	cp r20, r17						; compare the two X, Z
	brne statefalse2				;go to false message if not equal

			


	cpi r18, 10						; compare when end the cycle	
	brne Comp1More2

Comp1End2:     						;True, 1 beep + 'Different'

	rcall matching					
	rcall beepon
    rcall megadel
    rcall CLRDIS	
	rcall bigdel2
	pop r18
	pop r21
	pop r20
	pop r17
	ret

statefalse2:						;False Branch, 3 beeps + 'Match'
	rcall differently
	rcall megadel
	rcall beepon
	rcall bigdel2
	rcall beepon
	rcall bigdel2
	rcall beepon
	pop r18
	pop r21
	pop r20
	pop r17
	rjmp main2



;XXXXXXXXXXXXXXXXXXXXXXXXXXXXXXX  END OF RETURN    XXXXXXXXXXXXXXXXXXXXXXXXXXXXXX
;XXXXXXXXXXXXXXXXXXXXXXXXXXXXXXX  END OF RETURN    XXXXXXXXXXXXXXXXXXXXXXXXXXXXXX

;&&&&&&&&&&&&&&&&&&&&&&&&&&&&&&&  SENDING PACKAGES &&&&&&&&&&&&&&&&&&&&&&&&&&&&&&&
; the sending of packages works that the address to PM is stored in Z and then routine sends
; the message to thescanner using UART protocol

send_ReadSysPara:            		;Subroutine to send CP asking for System Parameters  	
	ldi r18, 12
	LDI ZH, HIGH(ReadSysPara*2)
	LDI ZL, LOW(ReadSysPara*2)
	rcall Mess1Out
	ret

send_TempleteNum:   				;Send CP for template number
	ldi r18, 12						;Load r18 with the number of bytes
	LDI ZH, HIGH(TempleteNum*2)		;Point the Z register to the correct database
	LDI ZL, LOW(TempleteNum*2)
	rcall Mess1Out					;call send routines
	ret

send_DeleteChar:              		;Send CP for Clear Memory
	ldi r18, 16
	LDI ZH, HIGH(DeleteChar*2)
	LDI ZL, LOW(DeleteChar*2)
	rcall Mess1Out
	ret

send_genimg:        				;Send CP for generate image
	ldi r18, 12
	LDI ZH, HIGH(genimg*2)
	LDI ZL, LOW(genimg*2)
	rcall Mess1Out
	ret

send_img2tBuff1:       				;Send CP for create character file, load to Buffer1
	ldi r18,13
	LDI ZH, HIGH(img2tBuff1*2)
	LDI ZL, LOW(img2tBuff1*2)
	rcall Mess1Out
	ret

send_img2tBuff2:             		;Send CP for create character file, load to Buffer2
	ldi r18,13
	LDI ZH, HIGH(img2tBuff2*2)
	LDI ZL, LOW(img2tBuff2*2)
	rcall Mess1Out
	ret

send_regmodel:            			;Send CP for create a template from Character files
	ldi r18,12
	LDI ZH, HIGH(regmodel*2)
	LDI ZL, LOW(regmodel*2)
	rcall Mess1Out
	ret

send_Store4:						; this one has to split the message and add variable (register) pointing																	
	ldi r18,12						; to the variable memory address in the device -> to prevent overwriting 
	LDI ZH, HIGH(2*Store4)			; THis adds fingerprint to the database of the scanner
	LDI ZL, LOW(2*Store4)
	rcall Mess1Out
	sts 0x0952, r25
									; now fine for 12
									; send variable location
	mov buffer,r25
	rcall UART_send_byte
	rcall UART_delay
									;send r 25			 
	push r25
	ldi r25, 00
	mov buffer,r25
	rcall UART_send_byte
	rcall UART_delay
	pop r25

	push r21						;contains the sum
	mov r21,r25
	sts 0x0954, r21					; this is checksum
	subi r21,$F2					;add 14 to 
	sts 0x0954, r21					; this is checksum 
	mov buffer,r21
	rcall UART_send_byte
									;rcall UART_delay
	sts 0x0956, r21						  
	pop r21
									;out portb, r25
	inc r25
	rcall bigdel
	ret


send_PreciseMatch:           
	ldi r18,12
	LDI ZH, HIGH(PreciseMatch*2)
	LDI ZL, LOW(PreciseMatch*2)
	rcall Mess1Out
	ret

send_Search:           
	ldi r18, $11
	LDI ZH, HIGH(Search*2)
	LDI ZL, LOW(Search*2)
	rcall Mess1Out
	ret

;*************************************SEND BYTE BY BYTE, Transmission ***********
;this routine sends byte by byte given message 
Mess1Out:
	push r17	  					;push to Stack

Mess1More:
	LPM 							;Load the CP from the SRAM location 
	MOV r17, r0						;R0 loaded with first byte in CP by def
	mov buffer,r17					;The Manual UART buffer loaded with the value
	rcall UART_send_byte			;call routine to send byte
	rcall UART_delay					
			  
	DEC r18							;r18 loaded in previous code with no. of bytes
	cpi r18, $0						;deincremented until no bytes left to send
	breq Mess1End					;End when all bytes are sent	
	ADIW ZL, $01					;Move onto next byte in CP 
	rjmp Mess1More
Mess1End:     
	pop r17							;return previous stack value
	ret

;*****                 SEND BYTE  bit by bit    *********************************
; This sends one byte using SW UART
UART_send_byte:	       
;UART_TxPort = PORTD 
;buffer = R23	
  
	ldi		r24, 10   				;counter that has 2 extra bits for the start and end of each byte
	com		buffer	         		;com of signal to be sent, set in Mess1out
	sec		                		;sets carry flag in SREG, to allow transmission

; 12 clock cycles here (without delays)	
uart_send_next_bit:													
	brcc	uart_send_1				;goes to send a 1, if 0, due to com	;2				                  
	cbi		UART_TxPort, 3			;clears bit for sending 
	rjmp	uart_wait

uart_send_1:																
	sbi		UART_TxPort, 3													;4
	nop																		;5

uart_wait:							;delay routine
	rcall 	UART_delay	
	rcall 	UART_delay

	nop	nop nop nop															;9
	lsr		buffer					;move onto next bit to send				;10
	dec		r24						;reduce counter							;11
	brne	uart_send_next_bit		;branches if not counted to 0			;12    
					
	sbi		UART_TxPort, 3			;send final stop bit
	ret								; retunr to send next byte
	

;*************************************** LCD Routines ***************************
;This Routine is copied from lectures:
;Display Initialization routine

Idisp:		
	RCALL DEL15ms					; wait 15ms for things to relax after power up           
	ldi r16,    $30					; Hitachi says do it...
	sts   $8000,r16                  
	RCALL DEL4P1ms					; Hitachi says wait 4.1 msec
	sts   $8000,r16					; and again I do what I'm told
	rcall Del49ms
	sts   $8000,r16					; here we go again folks
	rcall busylcd		
	ldi r16, $3F					; Function Set : 2 lines + 5x7 Font
	sts  $8000,r16
	rcall busylcd
	ldi r16,  $08					;display off
	sts  $8000, r16
	rcall busylcd		
	ldi r16,  $01					;display on
	sts  $8000,  r16
	rcall busylcd
	ldi r16, $38					;function set
	sts  $8000, r16
	rcall busylcd
	ldi r16, $0E					;display on
	sts  $8000, r16
	rcall busylcd
	ldi r16, $06                    ;entry mode set increment no shift
	sts  $8000,  r16
	rcall busylcd
	clr r16
	ret

;********************************************************************************
; This clears the display so we can start all over again
; given in lectures:
CLRDIS:
	ldi r16,$01					; Clear Display send cursor 
	sts $8000,r16				; to the most left position
	ret
;********************************************************************************
; A routine the probes the display BUSY bit
; given in lectures
   
busylcd:     
	lds r23, $8000					;access 
	sbrc r23, 7						;check busy bit  7
	rjmp busylcd
	ret								;return if clear

;********************************************************************************

Matching:							;Called by comparebasic2, Output 'Match' to LCD
	LDI ZH, HIGH(2*match)
	LDI ZL, LOW(2*match)
	LDI r18, 6						;number of characters or bytes
Mess1More22:						;Standard write to LCD code
	LPM 
	MOV r17, r0
	sts $C000, r17
	rcall busylcd
	DEC r18
	BREQ Mess1End22
	ADIW ZL, $01
	RJMP Mess1More22
Mess1End22:     
	ret
          

differently:						;Called by comparebasic2, Output 'Different' to LCD
	LDI ZH, HIGH(2*different)
	LDI ZL, LOW(2*different)
	LDI r18, 10						;number of characters or bytes
	rcall Mess1More22
	ret




;********************   DELAY ROUTINES ******************************************
BigDEL2:
	rcall Del49ms
	rcall Del49ms
	rcall Del49ms
	rcall Del49ms
	rcall Del49ms
	rcall Del49ms
	rcall Del49ms
	rcall Del49ms
	rcall Del49ms
	rcall Del49ms
	rcall Del49ms
	rcall Del49ms
	rcall Del49ms
	rcall Del49ms
	rcall Del49ms
	rcall Del49ms
	rcall Del49ms
	rcall Del49ms
	ret

BigDEL:
	rcall BigDEL2
	rcall BigDEL2
	ret

BigDEL3:
	rcall Del49ms
	rcall Del49ms
	rcall Del49ms
	rcall Del49ms
	rcall Del49ms
	ret

megadel:
	rcall BigDEL2
	rcall BigDEL2
	rcall BigDEL2
	rcall BigDEL2
	rcall BigDEL2	
	ret

DEL15ms:
	LDI XH, HIGH(19997)
	LDI XL, LOW (19997)
COUNT:  
	SBIW XL, 1
	BRNE COUNT
	RET

DEL4P1ms:
	LDI XH, HIGH(5464)
	LDI XL, LOW (5464)
COUNT1:
	SBIW XL, 1
	BRNE COUNT1
	RET 

DEL100mus:
	LDI XH, HIGH(131)
	LDI XL, LOW (131)
COUNT2:
	SBIW XL, 1
	BRNE COUNT2
	RET 

DEL49ms:
	LDI XH, HIGH(65535)
	LDI XL, LOW (65535)
COUNT3:
	SBIW XL, 1
	BRNE COUNT3
	RET 




;%%%%%%%%%%%%%%%%%%%%%%%%%%%%    Interrupt   %%%%%%%%%%%%%%%%%%%%%%%%%%%%%%%%%%%%

save_data_start352:
	push r17
	lds r17, UDR1
	st Y+, r17						; store byte received in USART1 to memory location
	pop r17
	reti


;%%%%%%%%%%%%%%%%%%%%%%%%%%%%%%%%%%%%%  Calling Actions  %%%%%%%%%%%%%%%%%%%%%%%%


; ~~~~~~~~~~~~~~~~~~~~~~~~~ WAIT FOR  BUTTION PRESS AND MOVE SOMWEHRE ~~~~~~~~~~~

waitforbuttonpress:					
	rcall waitforbuttonpresscycle
	rcall FirstScreen
	ret
waitforbuttonpresscycle:			;Subroutine to wait for Pin input
	in r21, PIND
	cpi r21, $FF
	breq waitforbuttonpresscycle
	rcall clrdis
	ret



FirstScreen:
									;here have list of conditions
	cpi r21,$7F						; pin 1
	breq action1call				; ACTION 1
	
	cpi r21, $BF					; PIN2
	breq action2call				; ACTION 2
	
	cpi r21, $DF					; PIN3
	breq action3call				;Action 3

	cpi r21, $EF					; PIN4
	breq SecondScreen				;Action 4

	ret

SecondScreen:
	rcall verification				;Required: Verify ID for Admin Access 
correct:
	rcall Welcome5
	rcall waitforbuttonpresscycle
									;here have list of conditions
	cpi r21,$7F						; pin 1
	breq action4call				; ACTION 1
	
	cpi r21, $BF					; PIN2
	breq action5call				; ACTION 2
	
	cpi r21, $DF					; PIN3
	breq action6call				;Action 3

	cpi r21, $EF					; PIN4
	breq action7call				;Action 4
	rjmp main2


actions:

action1call:
	rcall action1
	rjmp main2
action2call:
	rcall action2
	rjmp main2
action3call:
	rcall action3
	rjmp main2
action4call:
	rcall action4					;included
	rjmp main2
action5call:
	rcall action5
	rjmp main2
action6call:
	rcall action6
	rjmp main2
action7call:
	rjmp main2

;%%%%%%%%%%%%%%%%%%%%%%%       Verification        %%%%%%%%%%%%%%%%%%%%%%%%%%%%%% 
Verification:						;Checks 0x0750 to see if Password subroutine-
	rcall action3					;-was reached
	lds r16, 0x0750 
	cpi r16, 22
	breq continue
	rjmp main2						;Jumps to Screen1 if not
	ret

continue:							;Called if 0x0750 has been changed by Password
	rcall message_ID_recognised
	rcall clear750
	rcall bigdel
	rjmp correct




;^^^^^^^^^^^^^^^^^^^^^^^^^DATABASE TO SRAM  MATCH   ^^^^^^^^^^^^^^^^^^^^^^^^^^^^^

DATABASE_TO_SRAM:					;saves to 0x0300
	push r20

makingZalocation:
	ldi ZH, HIGH(compare_database*2)	;leave as 16 bit
    ldi ZL, LOW(compare_database*2)
	rcall step_by_step_LOADING	
	pop r20
	ret 

;^^^^^^^^^^^^^^^^^^^^^^^^^^^DATABASE TO SRAM SEARCH ^^^^^^^^^^^^^^^^^^^^^^^^^^^^^


 DATABASE_TO_SRAM4:					;saves to 0x0300
	push r20

makingZalocation4:
	ldi ZH, HIGH(compare_database2*2);leave as 16 bit
    ldi ZL, LOW(compare_database2*2)
	rcall step_by_step_LOADING	
	pop r20 
	ret

;<<<<<<<<<<<<<<<<<<<<< Subroutine for databases >>>>>>>>>>>>>>>>>>>>>>>>>>>>>>>>>
step_by_step_LOADING:				; this stores given message from  PM (Z) to the  SRAM location (X)
	ldi r20, 12						;counter
	ldi XH, high(compare_address)	;create 16 bit address? ;0x0300
	ldi XL, low(compare_address)	;Leave as 8 bit

program_to_memory:
	lpm 
	ADIW ZL, $01
	dec r20	
	
	st X+, r0						;don't need sts, if using X
									
	cpi r20, $0						;end if counted
	brne program_to_memory
	ret

;???????????????????????????? Alarm    ??????????????????????????????????????????
									;rings once for correct finger
									;three times incorrect (see Statefalse)

beepon:								; turns on beep alarm - sound generator
	ldi r17, $FF
	out portB, r17					;Port B used to output signals
	rcall del49ms
	rcall del49ms
	rcall del49ms
	rcall del49ms
	rcall del49ms
	rcall del49ms
	ldi r17, $00
	out portB, r17
    ret
